nikspolaroid/eplan-vfd-conveyor-cabinet/fusion-3d/CAB1_VFD_conveyor_cabinet.step

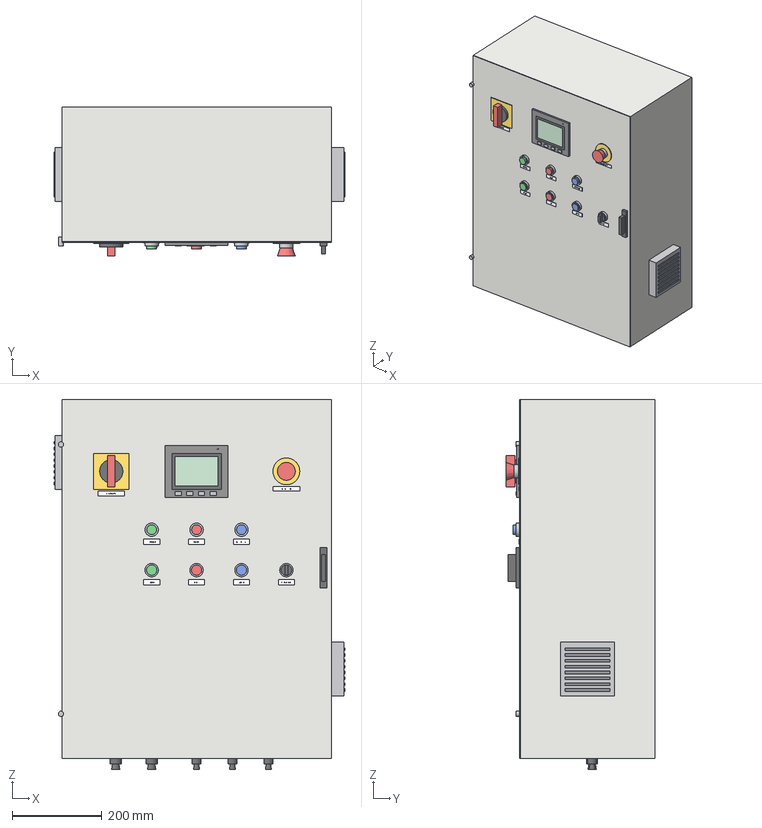
[picture p3: CAD file, 2026-11-06]
fusion-3d/CAB1_VFD_conveyor_cabinet.step
647.0 x 332.0 x 824.0 mm
