nikspolaroid/eplan-vfd-conveyor-cabinet/(list of files, cad)

Other CAD files:
fusion-3d/CAB1_VFD_conveyor_cabinet.f3d
