nikspolaroid/eplan-vfd-conveyor-cabinet/docs/CAB1_VFD_CONVEYOR_schematic.pdf

93415

## Petersgasse

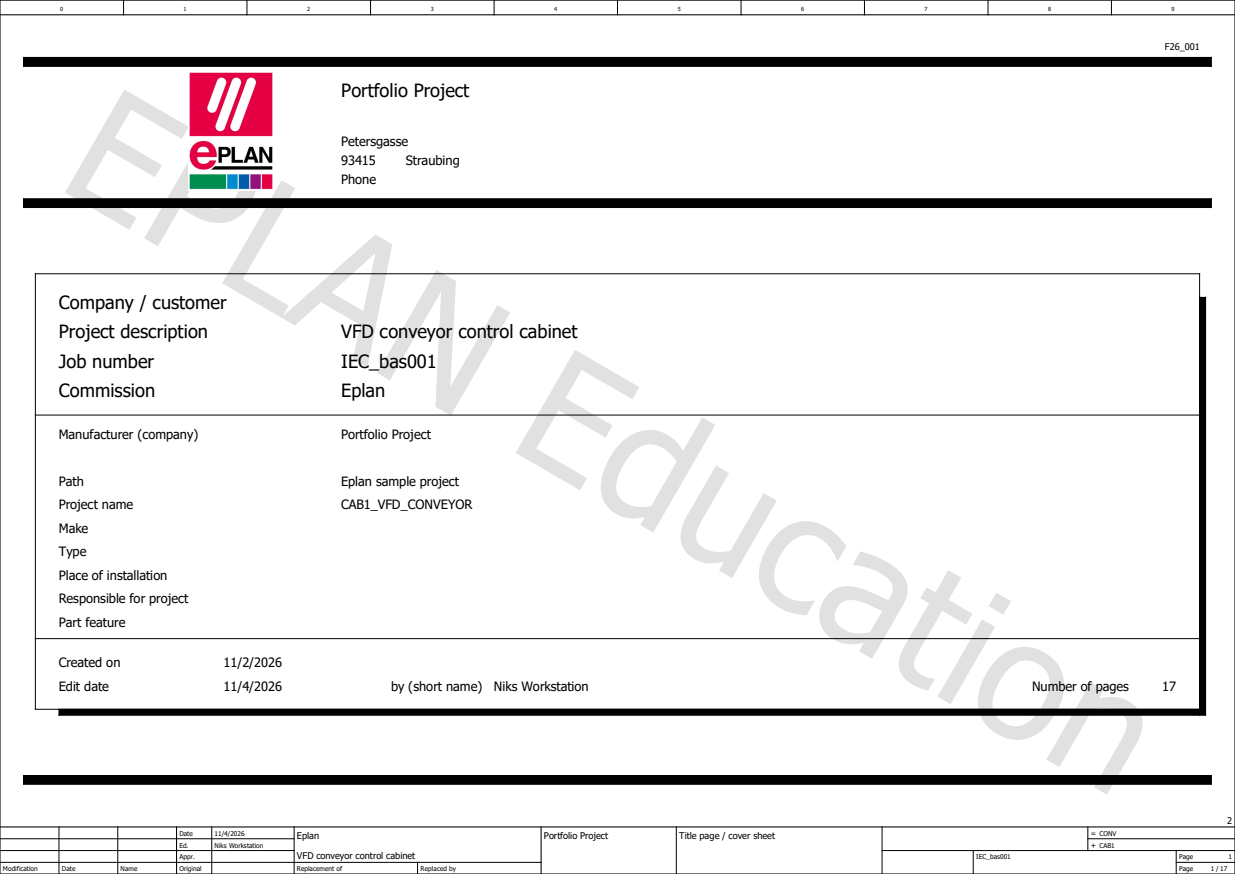
[picture p4: page 1]
Portfolio Project; Project description; VFD conveyor control cabinet; Commission; Edit date; IEC_bas001; Created on; Job number; Niks Workstation; Manufacturer (company); Project name; CAB1_VFD_CONVEYOR; Phone; Company / customer; Eplan; Straubing

Path
Make
Type
Place of installation
Responsible for project
Part feature

Eplan sample project

by (short name)

Number of pages

11/4/2026 | Eplan VFD conveyor control cabinet | Portfolio Project | Title page / cover sheet | = CONV

Ed. | Niks Workstation | | | | + CAB1
Appr. | | | | | IEC_bas001 | Page

Modification | Date | Name | Original | | Replacement of | Replaced by | | | | 1 / 17

Page | Page type | Page description | Date | Edited by

# Table of contents

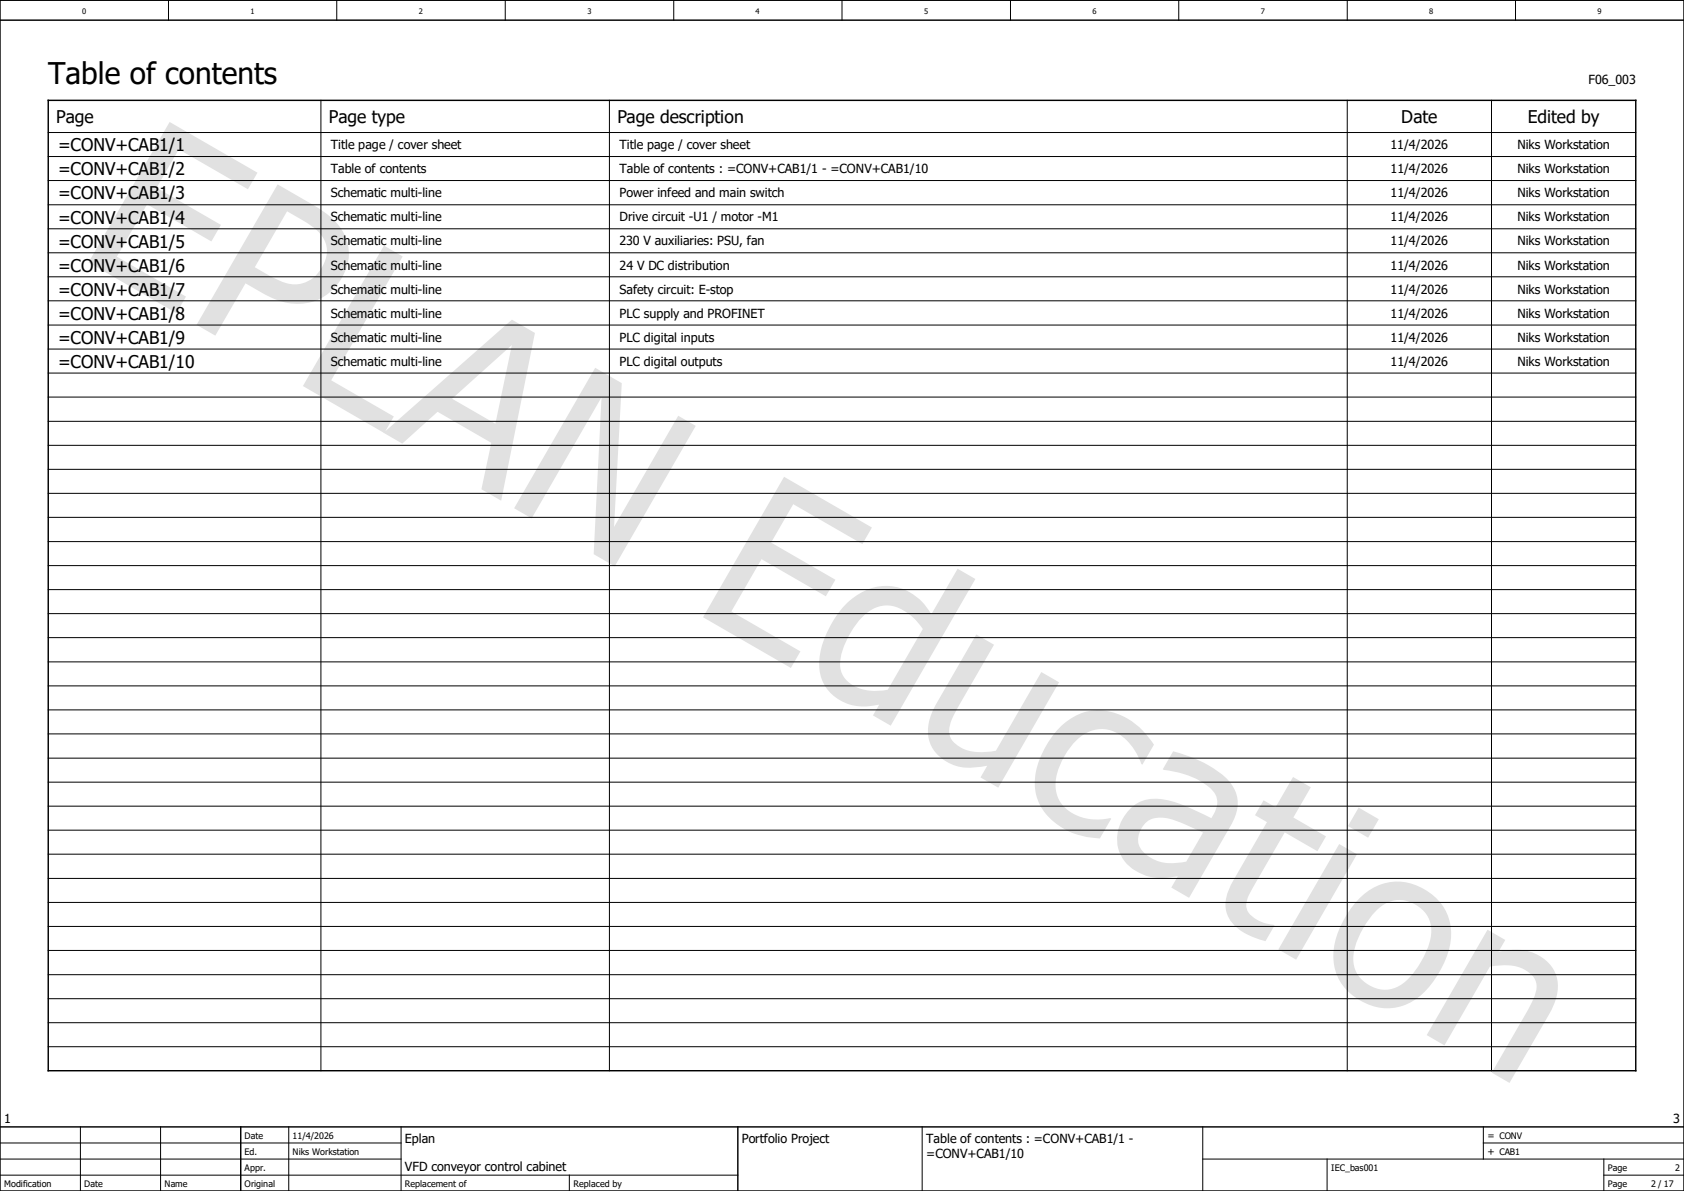
[picture p5: page 2]

=CONV+CAB1/1 | Title page / cover sheet | | 11/4/2026 Title page / cover sheet | Niks Workstation
=CONV+CAB1/2 | Table of contents | | 11/4/2026 Table of contents : =CONV+CAB1/1 - =CONV+CAB1/10 | Niks Workstation
=CONV+CAB1/3 | Schematic multi-line | Power infeed and main switch | 11/4/2026 | Niks Workstation
=CONV+CAB1/4 | Schematic multi-line | Drive circuit -U1 / motor -M1 | 11/4/2026 | Niks Workstation
=CONV+CAB1/5 | Schematic multi-line | 230 V auxiliaries: PSU, fan | 11/4/2026 | Niks Workstation
=CONV+CAB1/6 | Schematic multi-line | 24 V DC distribution | 11/4/2026 | Niks Workstation
=CONV+CAB1/7 | Schematic multi-line | Safety circuit: E-stop | 11/4/2026 | Niks Workstation
=CONV+CAB1/8 | Schematic multi-line | PLC supply and PROFINET | 11/4/2026 | Niks Workstation
=CONV+CAB1/9 | Schematic multi-line | PLC digital inputs | 11/4/2026 | Niks Workstation
=CONV+CAB1/10 | Schematic multi-line | PLC digital outputs | 11/4/2026 | Niks Workstation

Table of contents : =CONV+CAB1/1 -
=CONV+CAB1/10

-W0 | 3⁻1 | 3⁻1 | 3⁻1 4⁻1 | 4⁻1 | 4⁻1 | 4⁻15⁻1

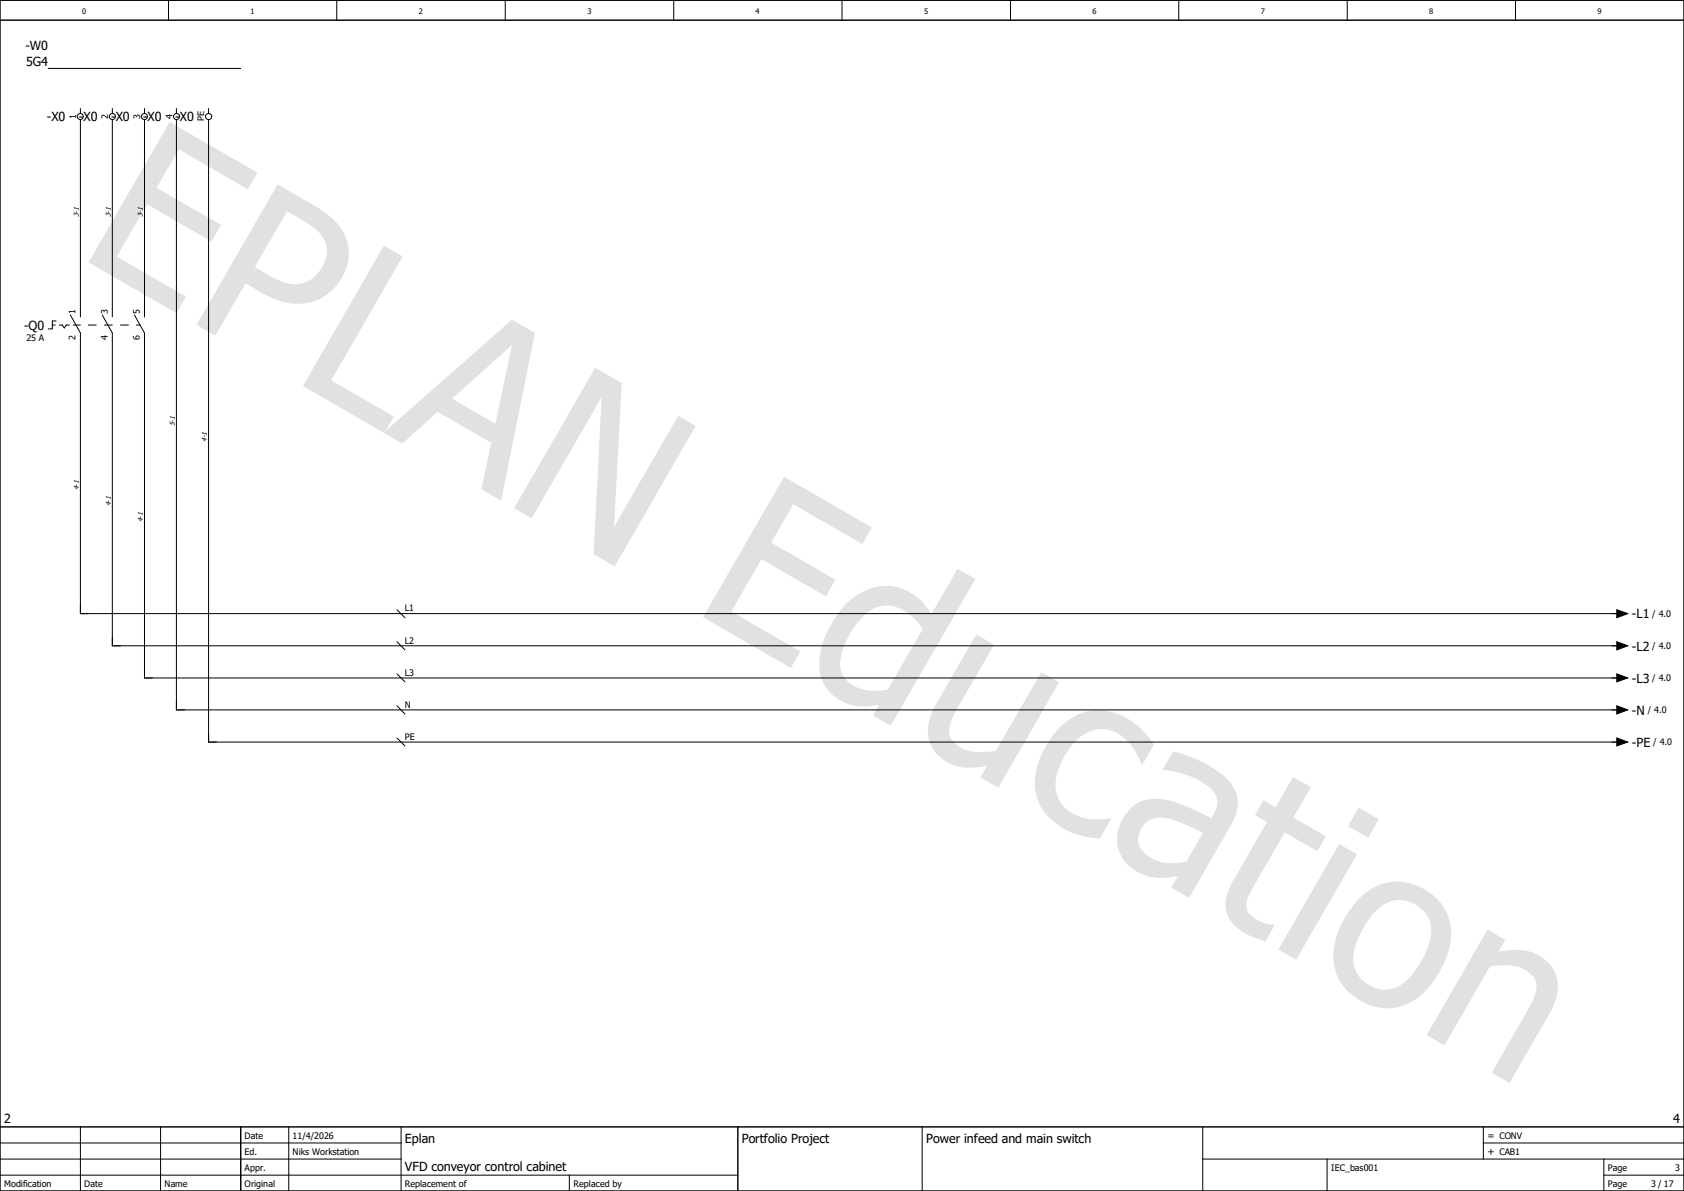
[picture p6: page 3]

Power infeed and main switch

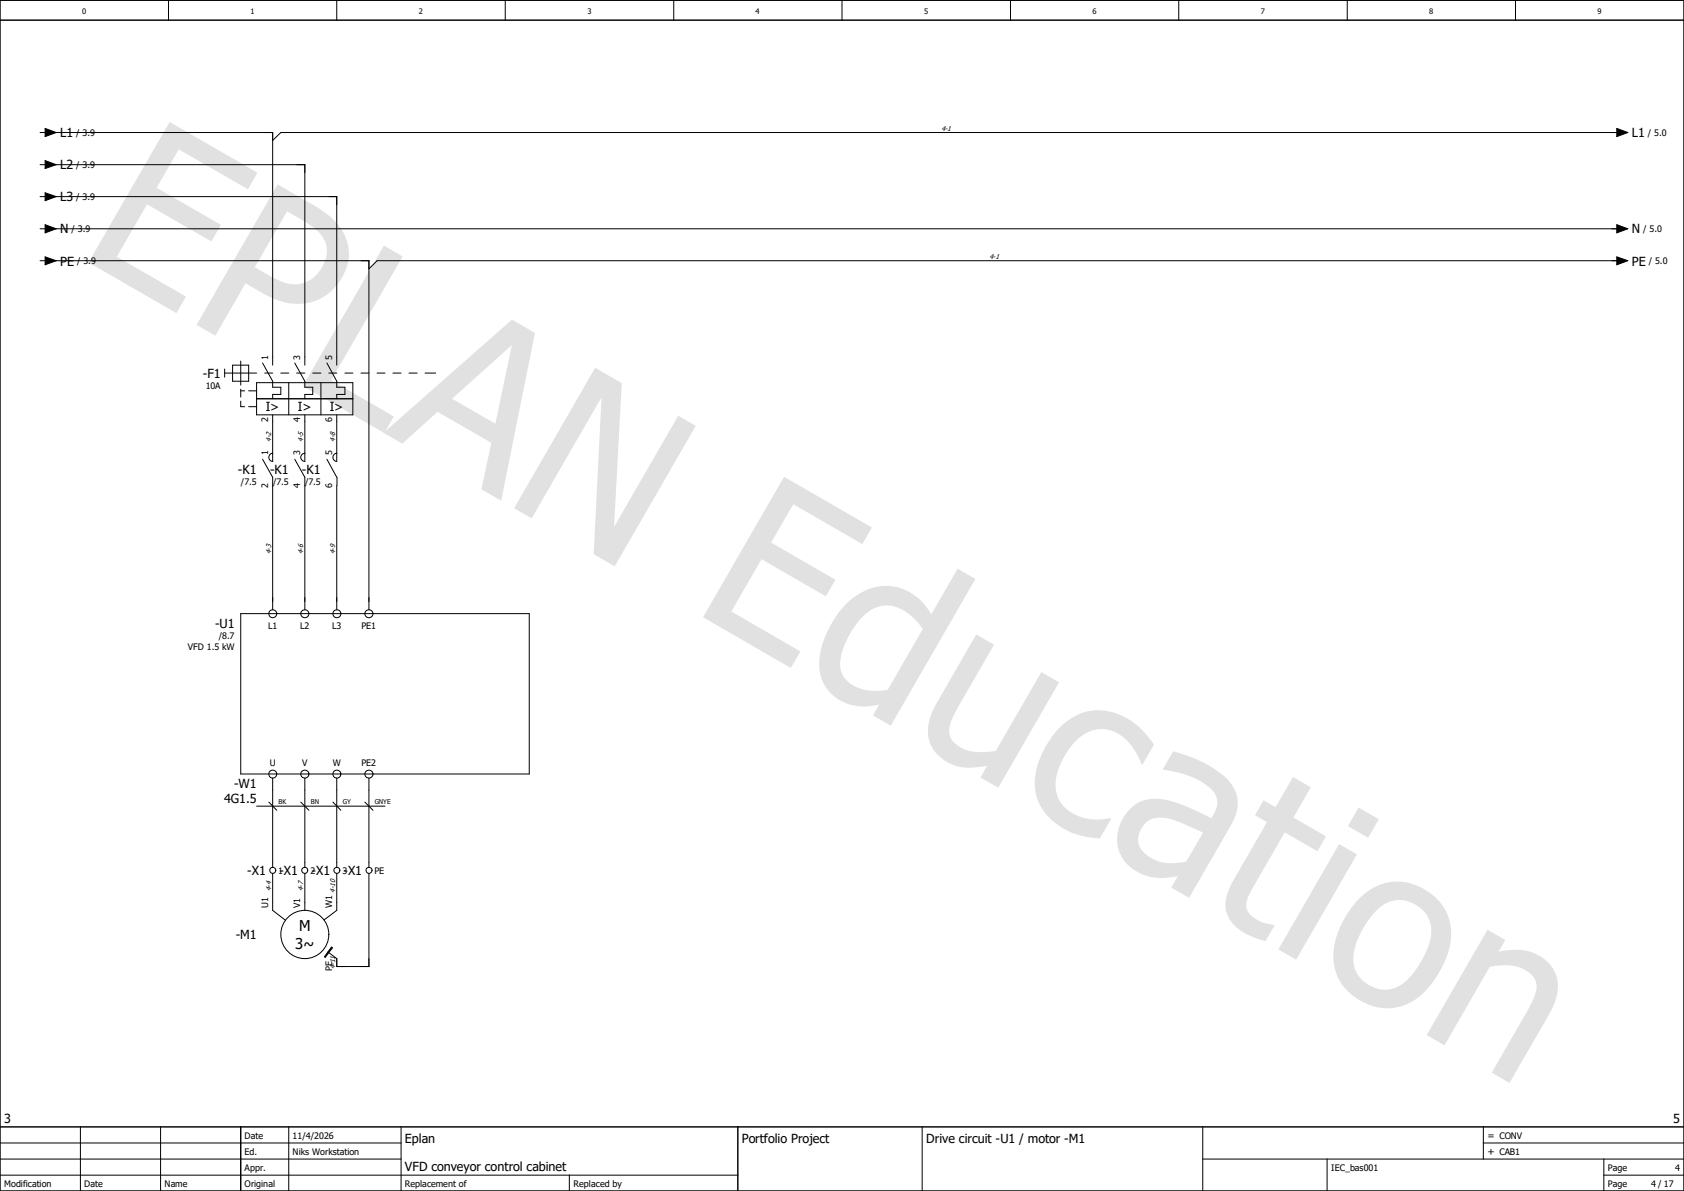
[picture p7: page 4]
-U1 /8.7 VFD 1.5 kW; GNYE U¹

Drive circuit -U1 / motor -M1

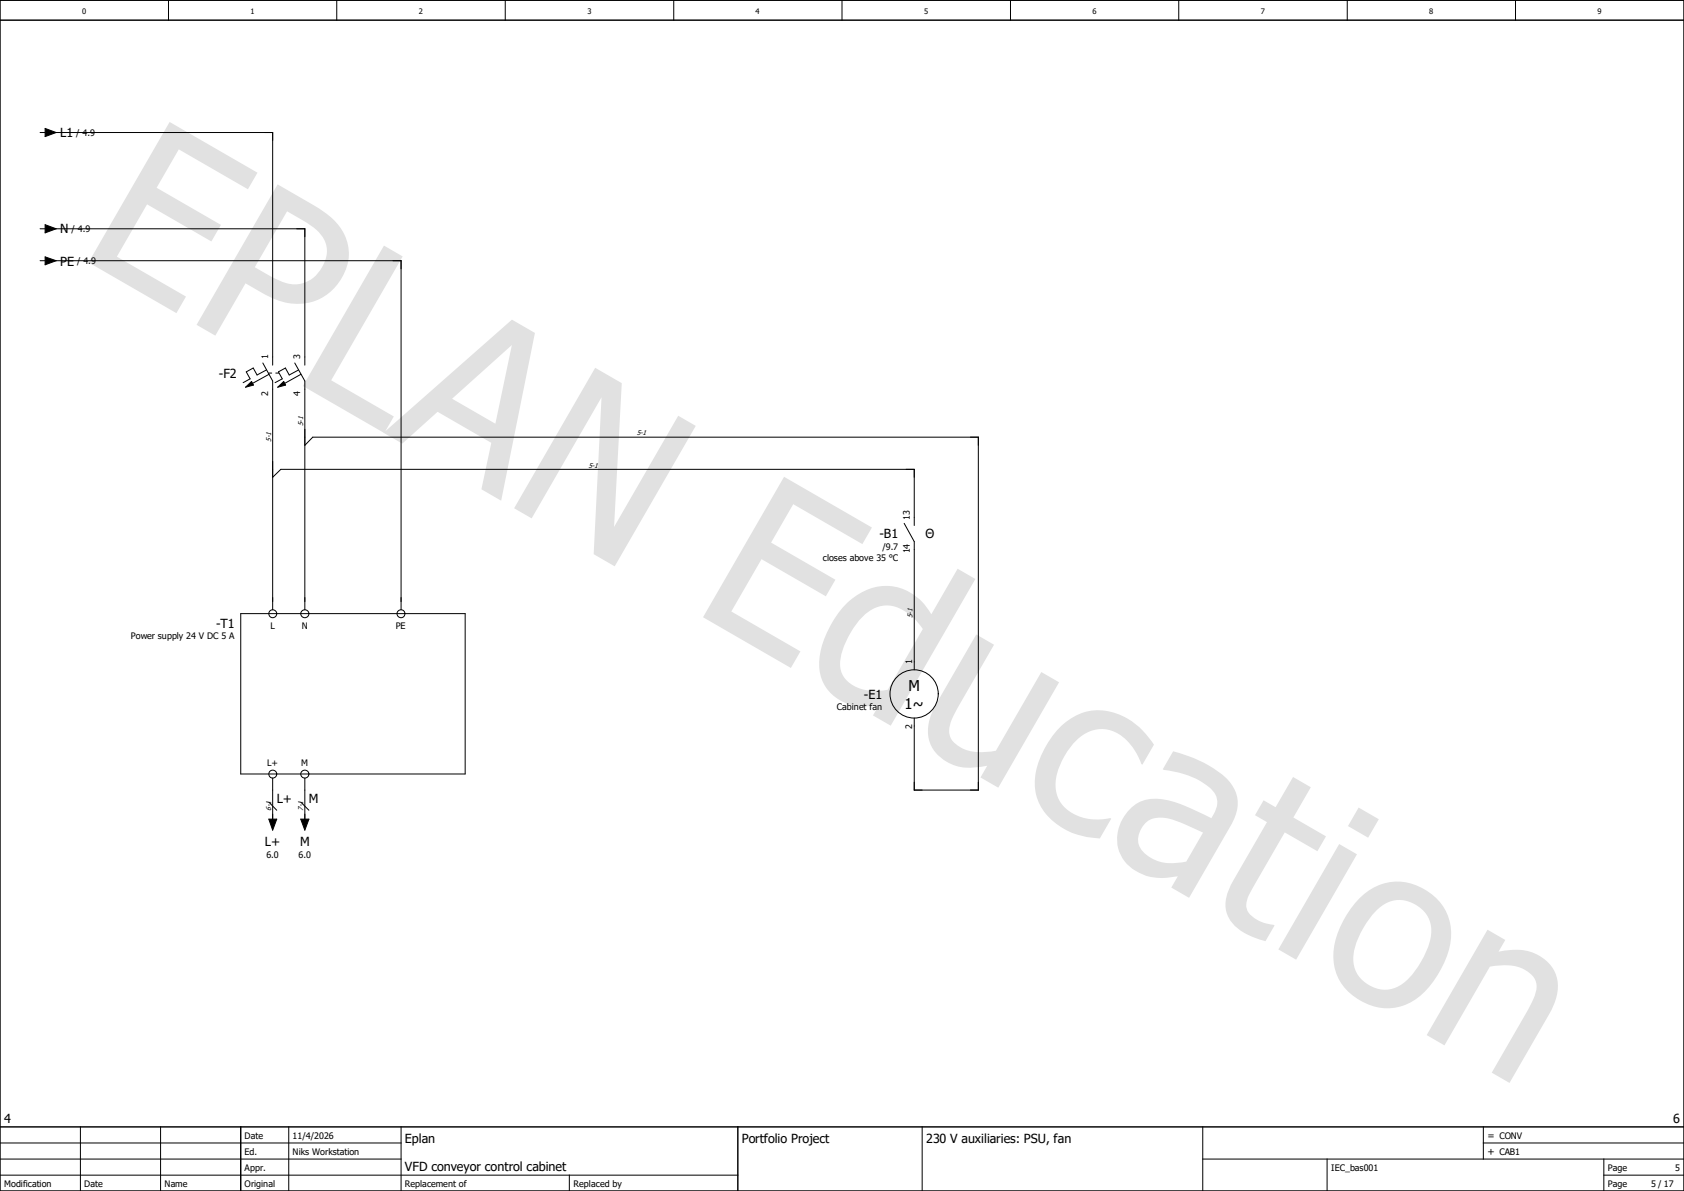
[picture p8: page 5]
-B1 /9.7 closes above 35 °C; Cabinet fan

Power supply 24 V DC 5 A

230 V auxiliaries: PSU, fan

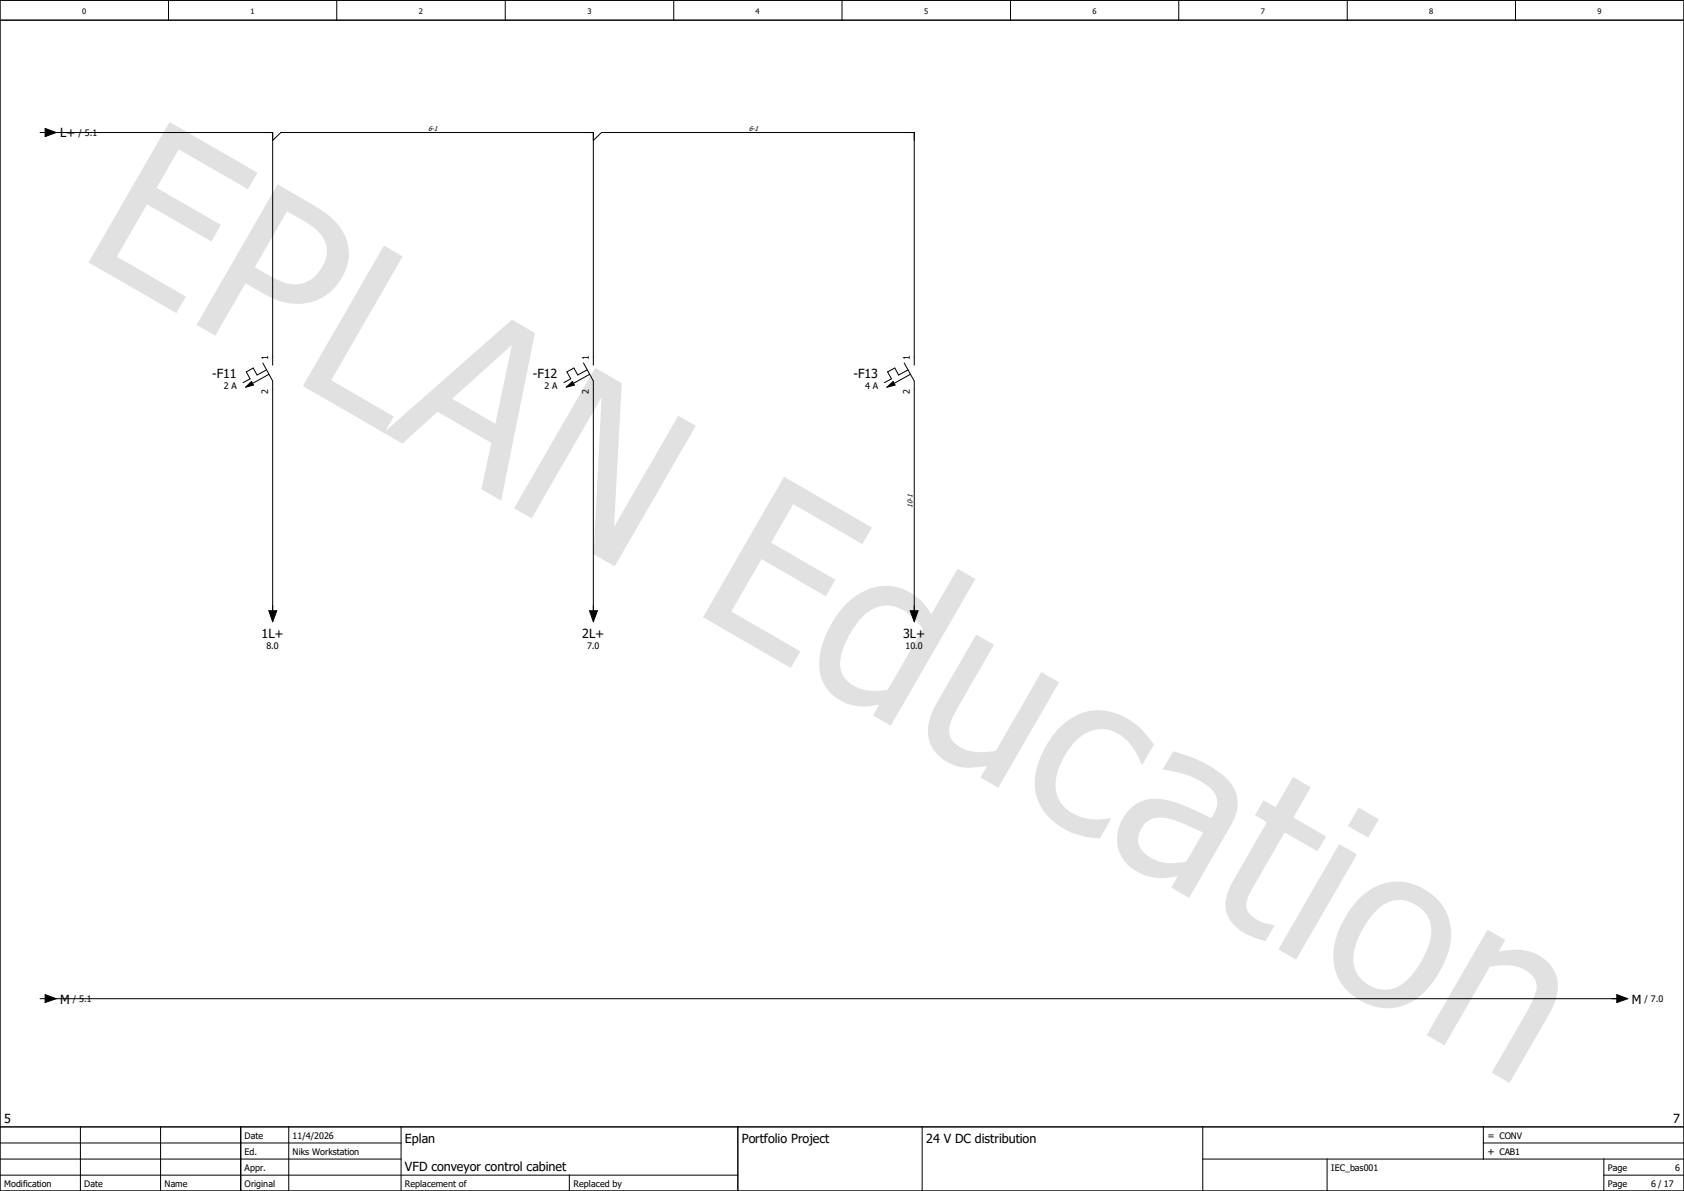
[picture p9: page 6]
24 V DC distribution

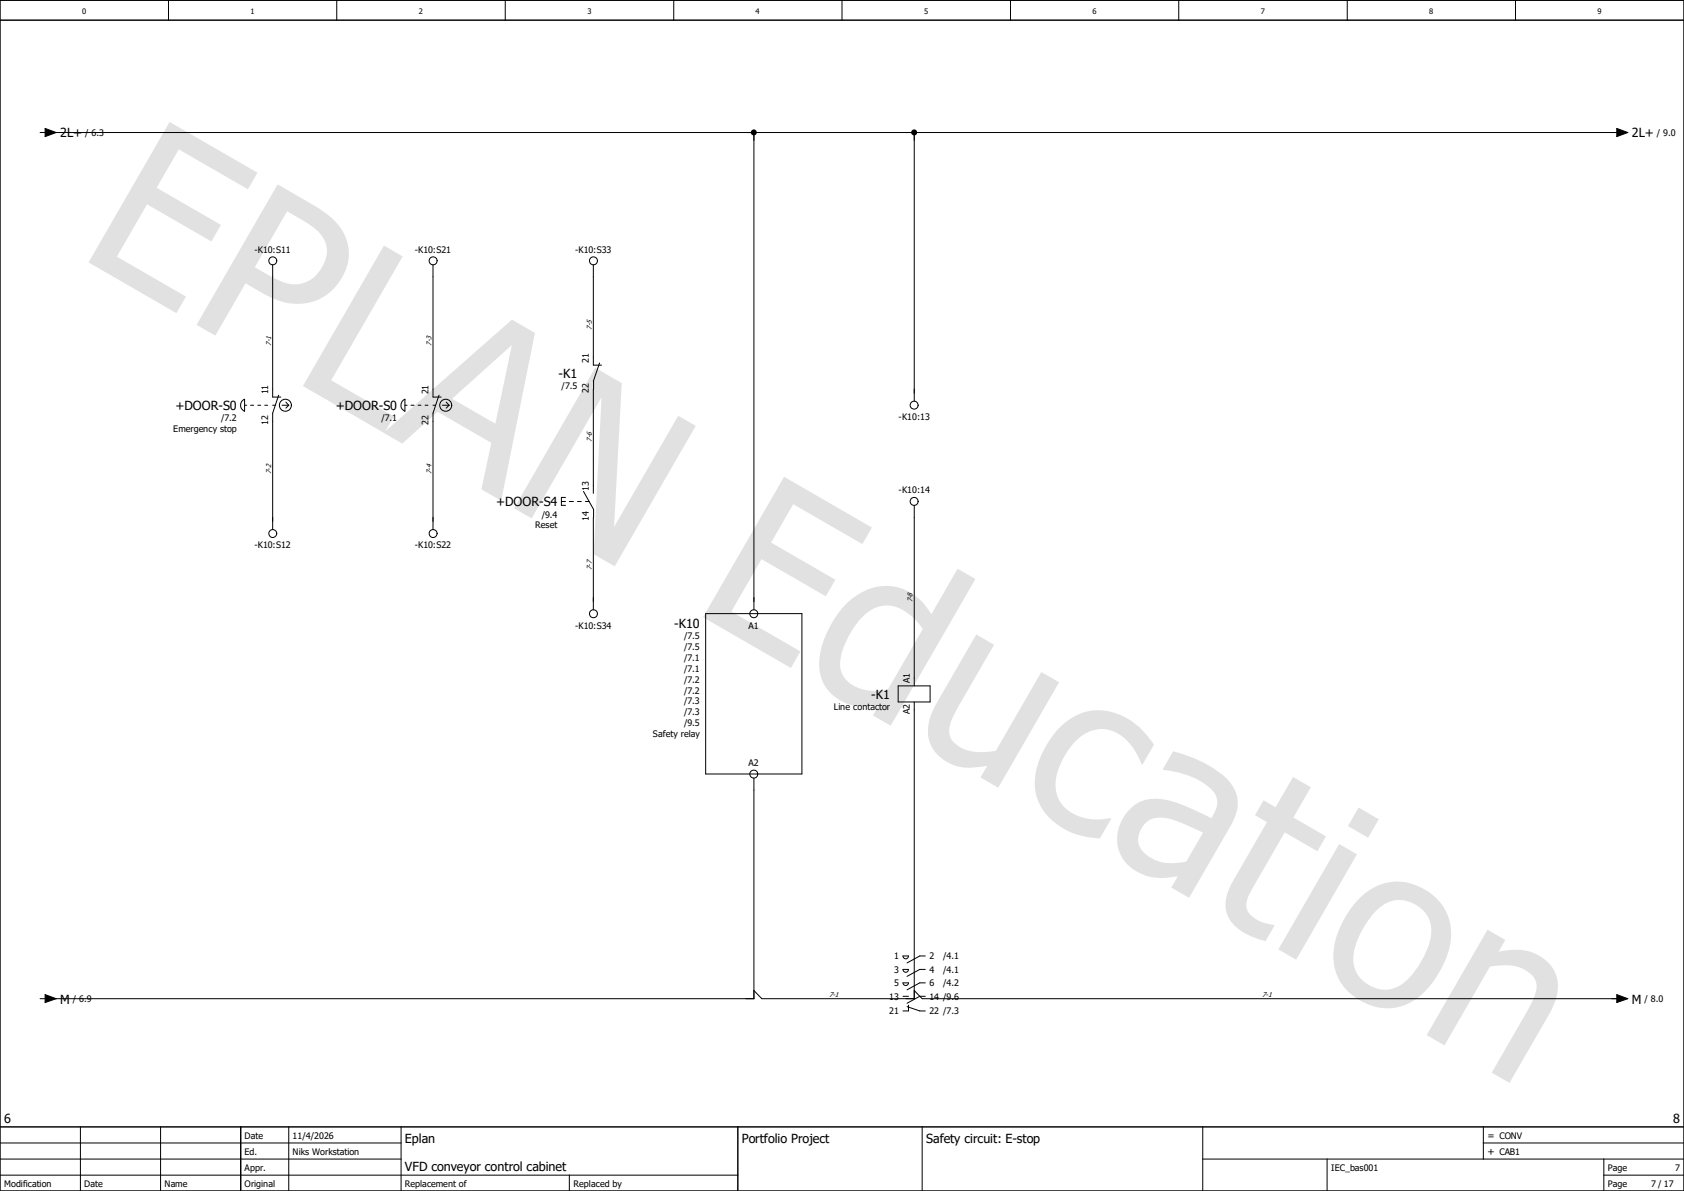
[picture p10: page 7]
+DOOR-S0 /7.2; Emergency stop; +DOOR-S0; +DOOR-S4 /9.4 Reset; -K10 /7.5 /7.5 /7.1 /7.1 /7.2 /7.2 /7.3 /7.3 /9.5 Safety relay; -K1 Line contactor

Safety circuit: E-stop

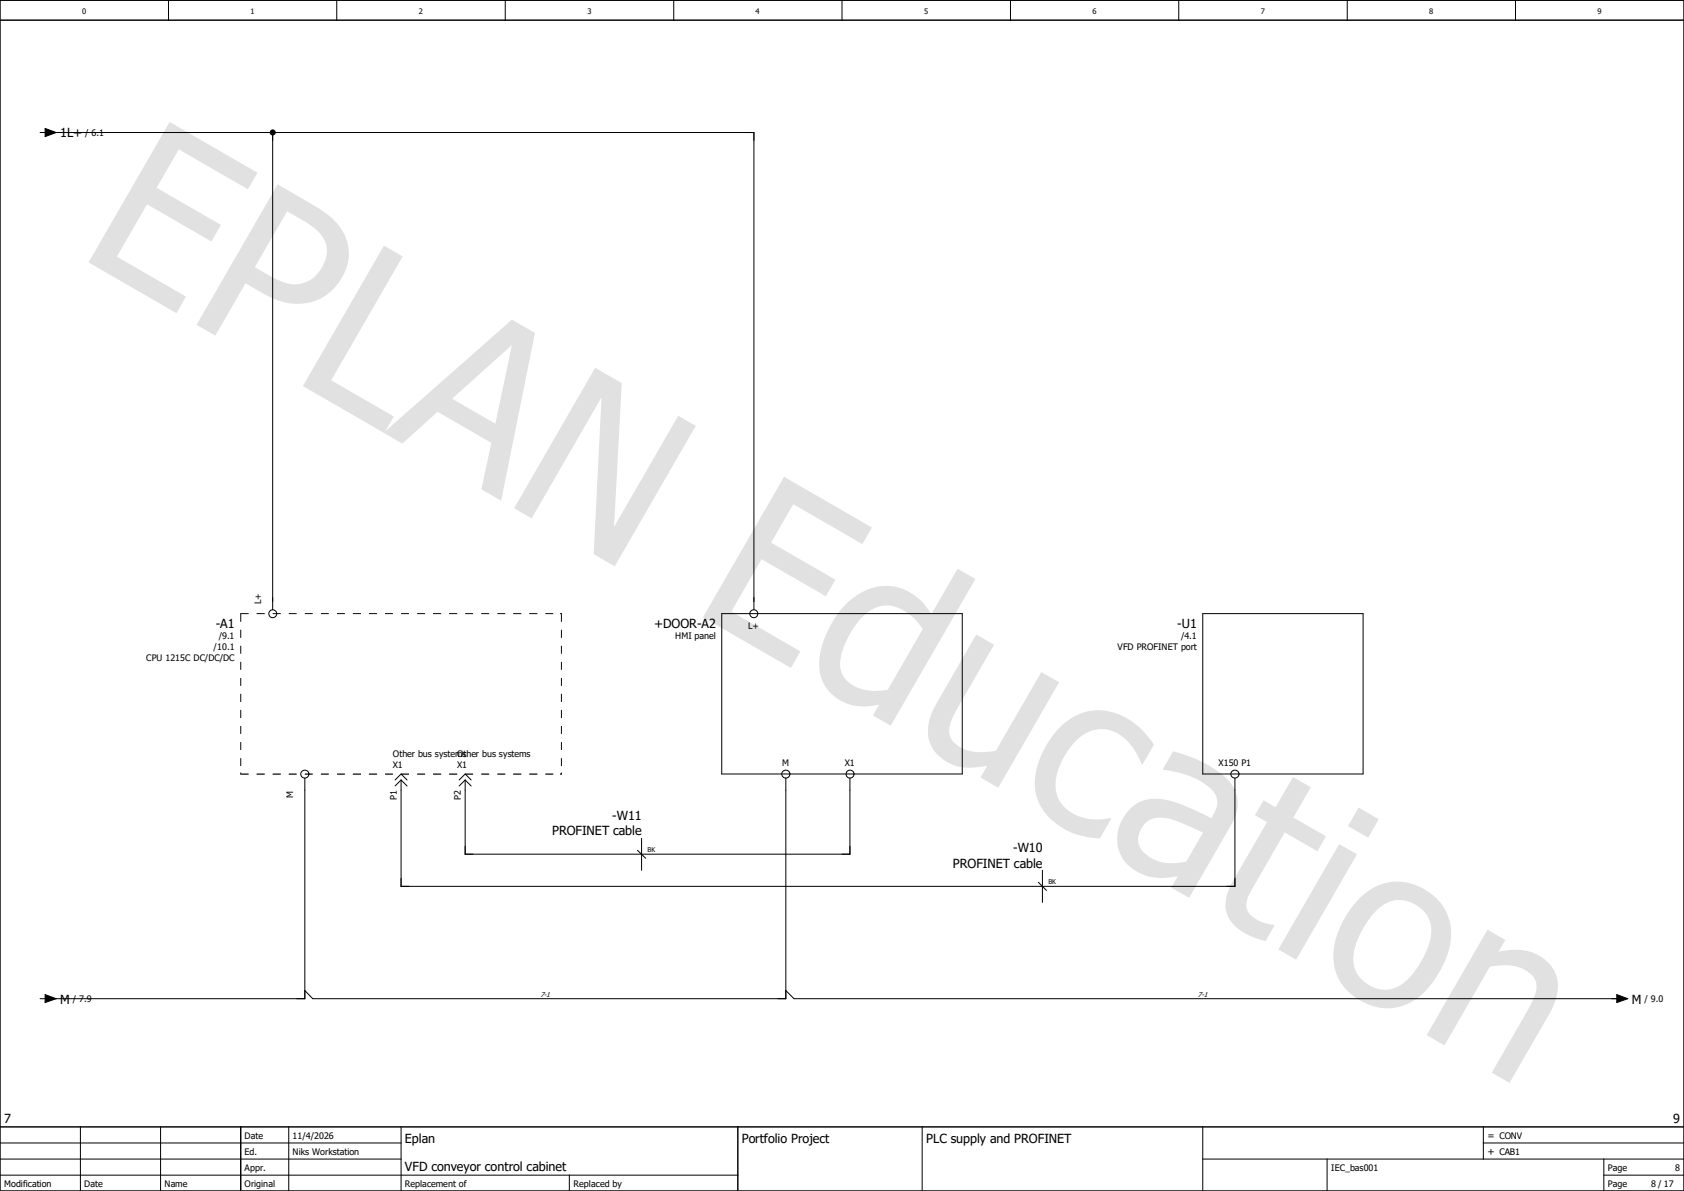
[picture p11: page 8]
CPU 1215C DC/DC/DC; Other bus systemsP2; +DOOR-A2 HMI panel; PROFINET cable

VFD PROFINET port

Other bus systems

PLC supply and PROFINET

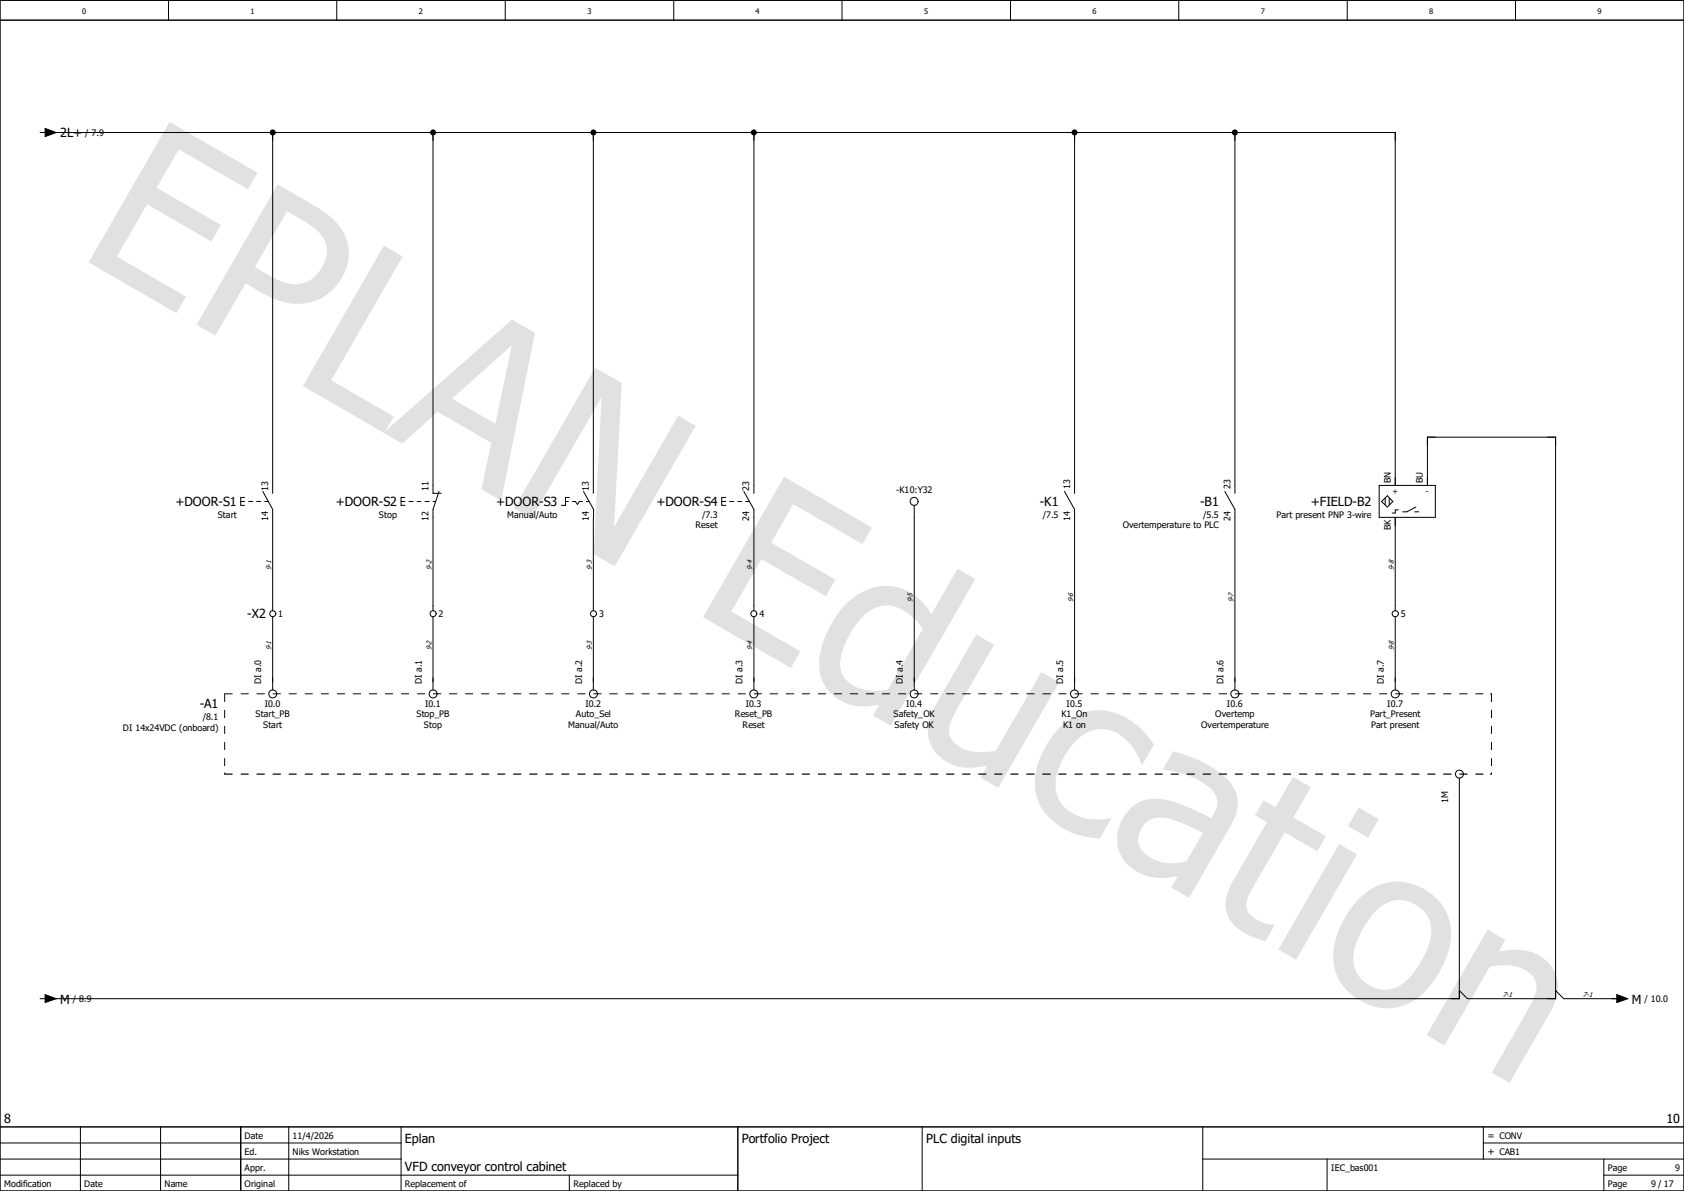
[picture p12: page 9]
-A1 /8.1 DI 14x24VDC (onboard); I0.0 Start_PB; Start DI a.0; I0.1 Stop_PB; Stop DI a.1; I0.2 Auto_Sel; I0.3 Reset_PB; Reset DI a.3; I0.4 Safety_OK; I0.6 Overtemp; Overtemperature DI a.6; I0.7 Part_Present; Part present DI a.7; +DOOR-S1; Start; +DOOR-S4 /7.3; +DOOR-S2; Stop; +DOOR-S3; Manual/Auto; +FIELD-B2

Reset ¹¹ ¹²

Overtemperature to PLC

Part present PNP 3-wire

Manual/Auto DI a.2

Safety OK DI a.4

PLC digital inputs

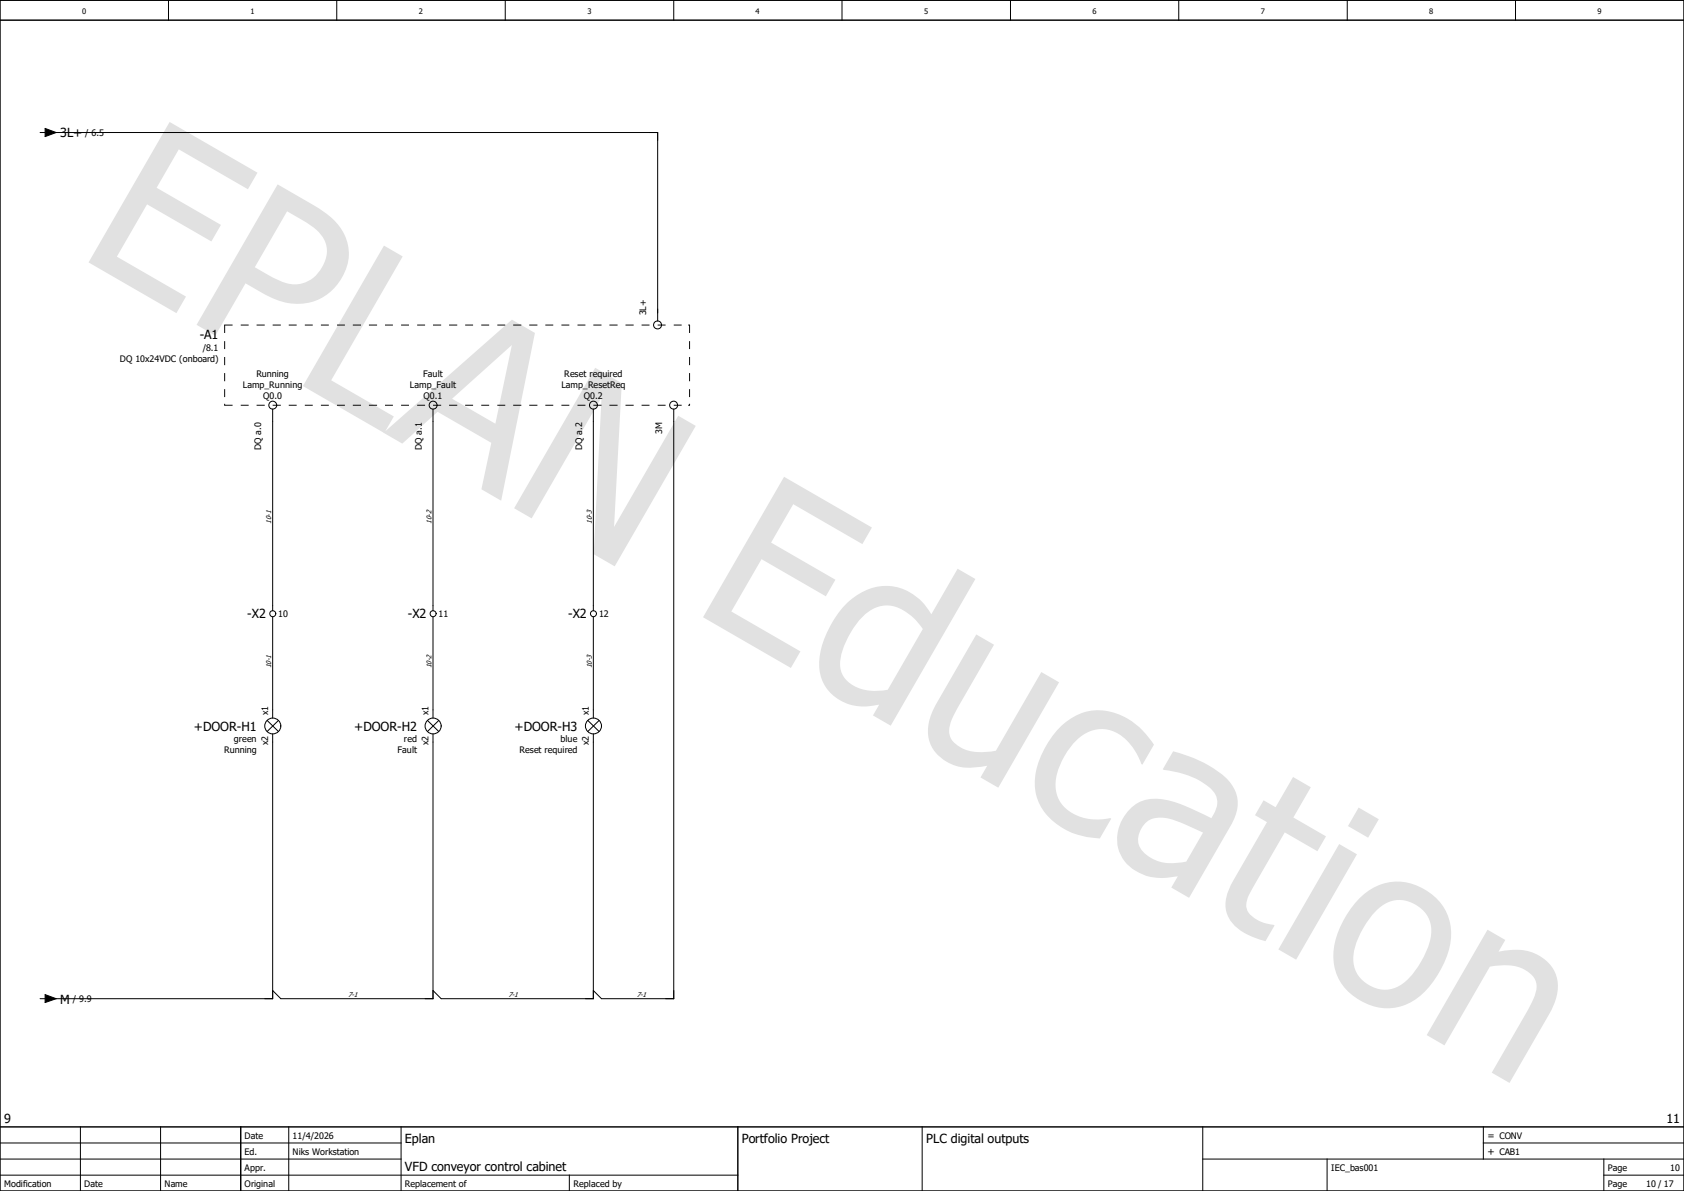
[picture p13: page 10]
DQ 10x24VDC (onboard); Lamp_Running; Running; Lamp_Fault; Fault; Lamp_ResetReq; Reset required; +DOOR-H1 green; +DOOR-H2 red; +DOOR-H3 blue; Reset required ¹⁰⁻¹

PLC digital outputs

# 11 / Cable type

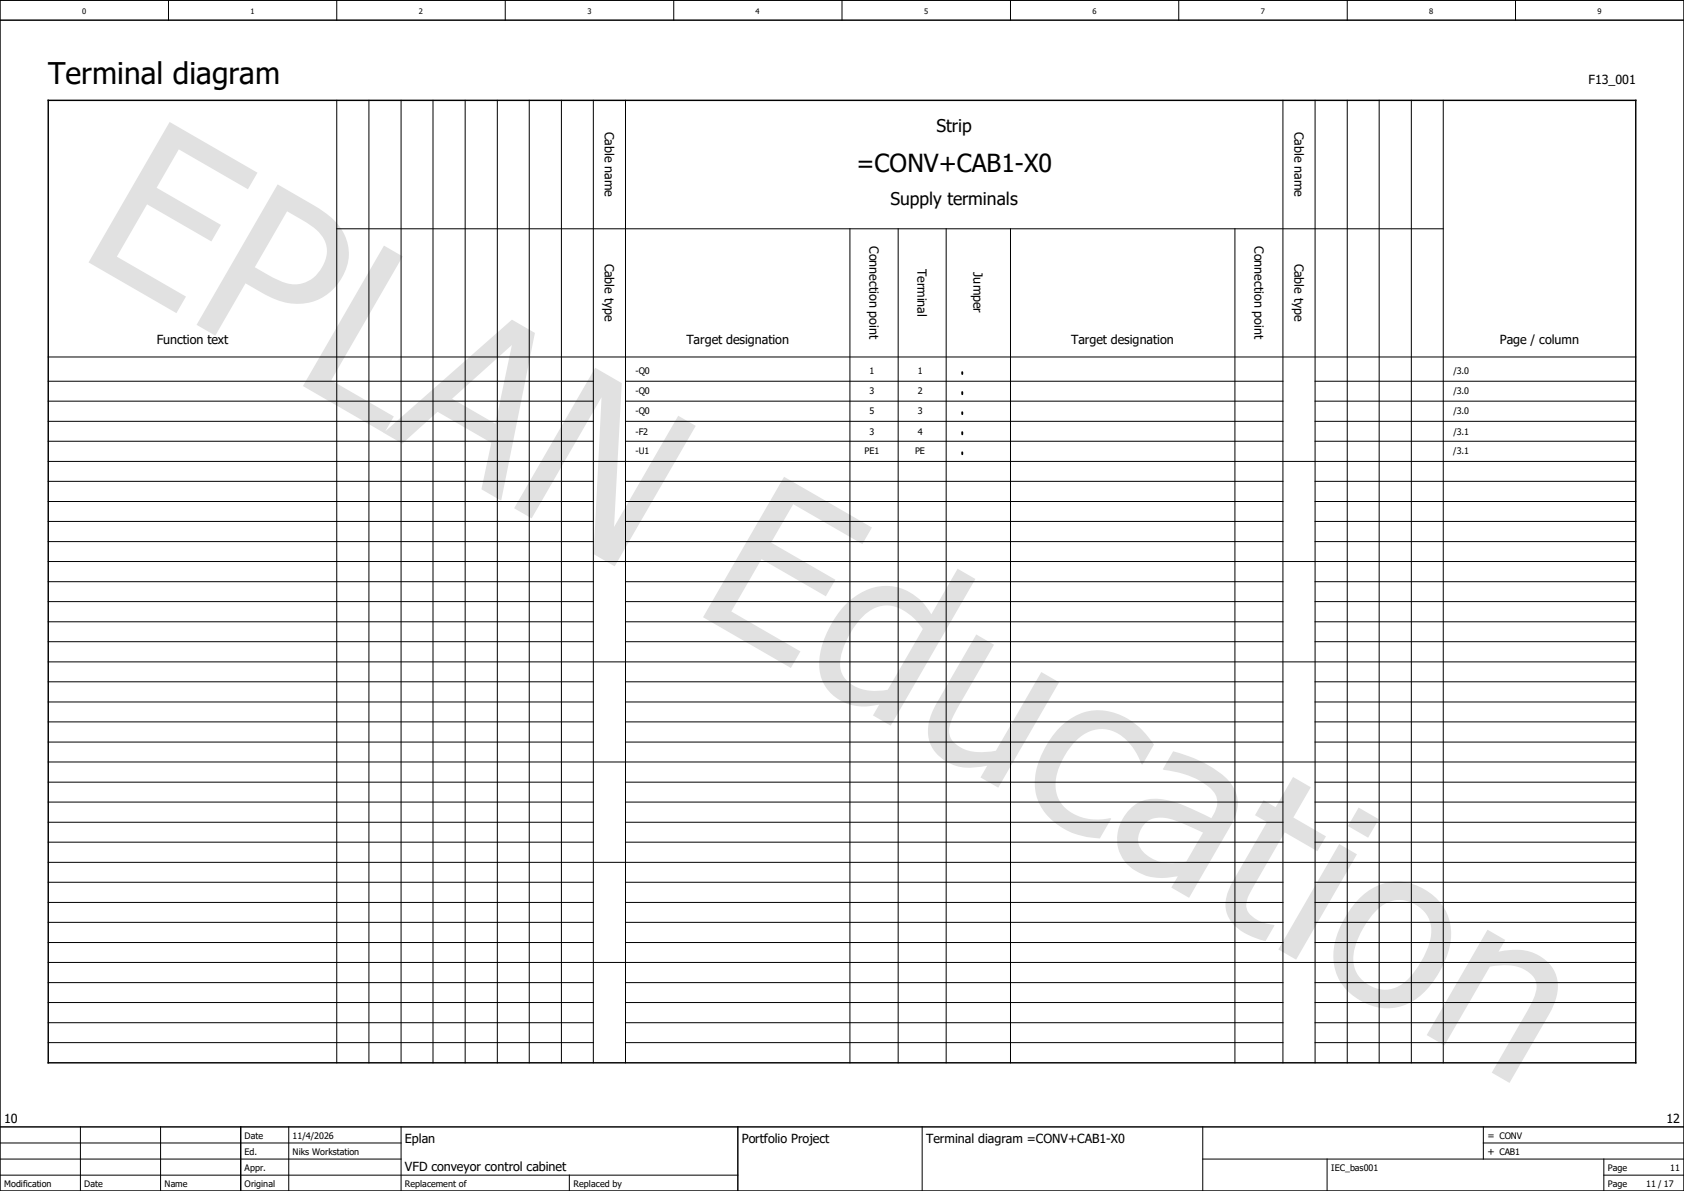
[picture p14: page 11]
Page / column Cable name; Strip

Terminal diagram Function text | | Connection point =CONV+CAB1-X0 Supply terminals | | | | | F13_001 Cable name

Target designation | | | Jumper | Target designation Cable type | Connection point Terminal

-Q0 | 1 | 1 | | | | /3.0
-Q0 | 3 | 2 | | | | /3.0
-Q0 | 5 | 3 | | | | /3.0
-F2 | 3 | 4 | | | | /3.1
-U1 | PE1 | PE | | | | /3.1

Terminal diagram =CONV+CAB1-X0

# 12 / Cable type

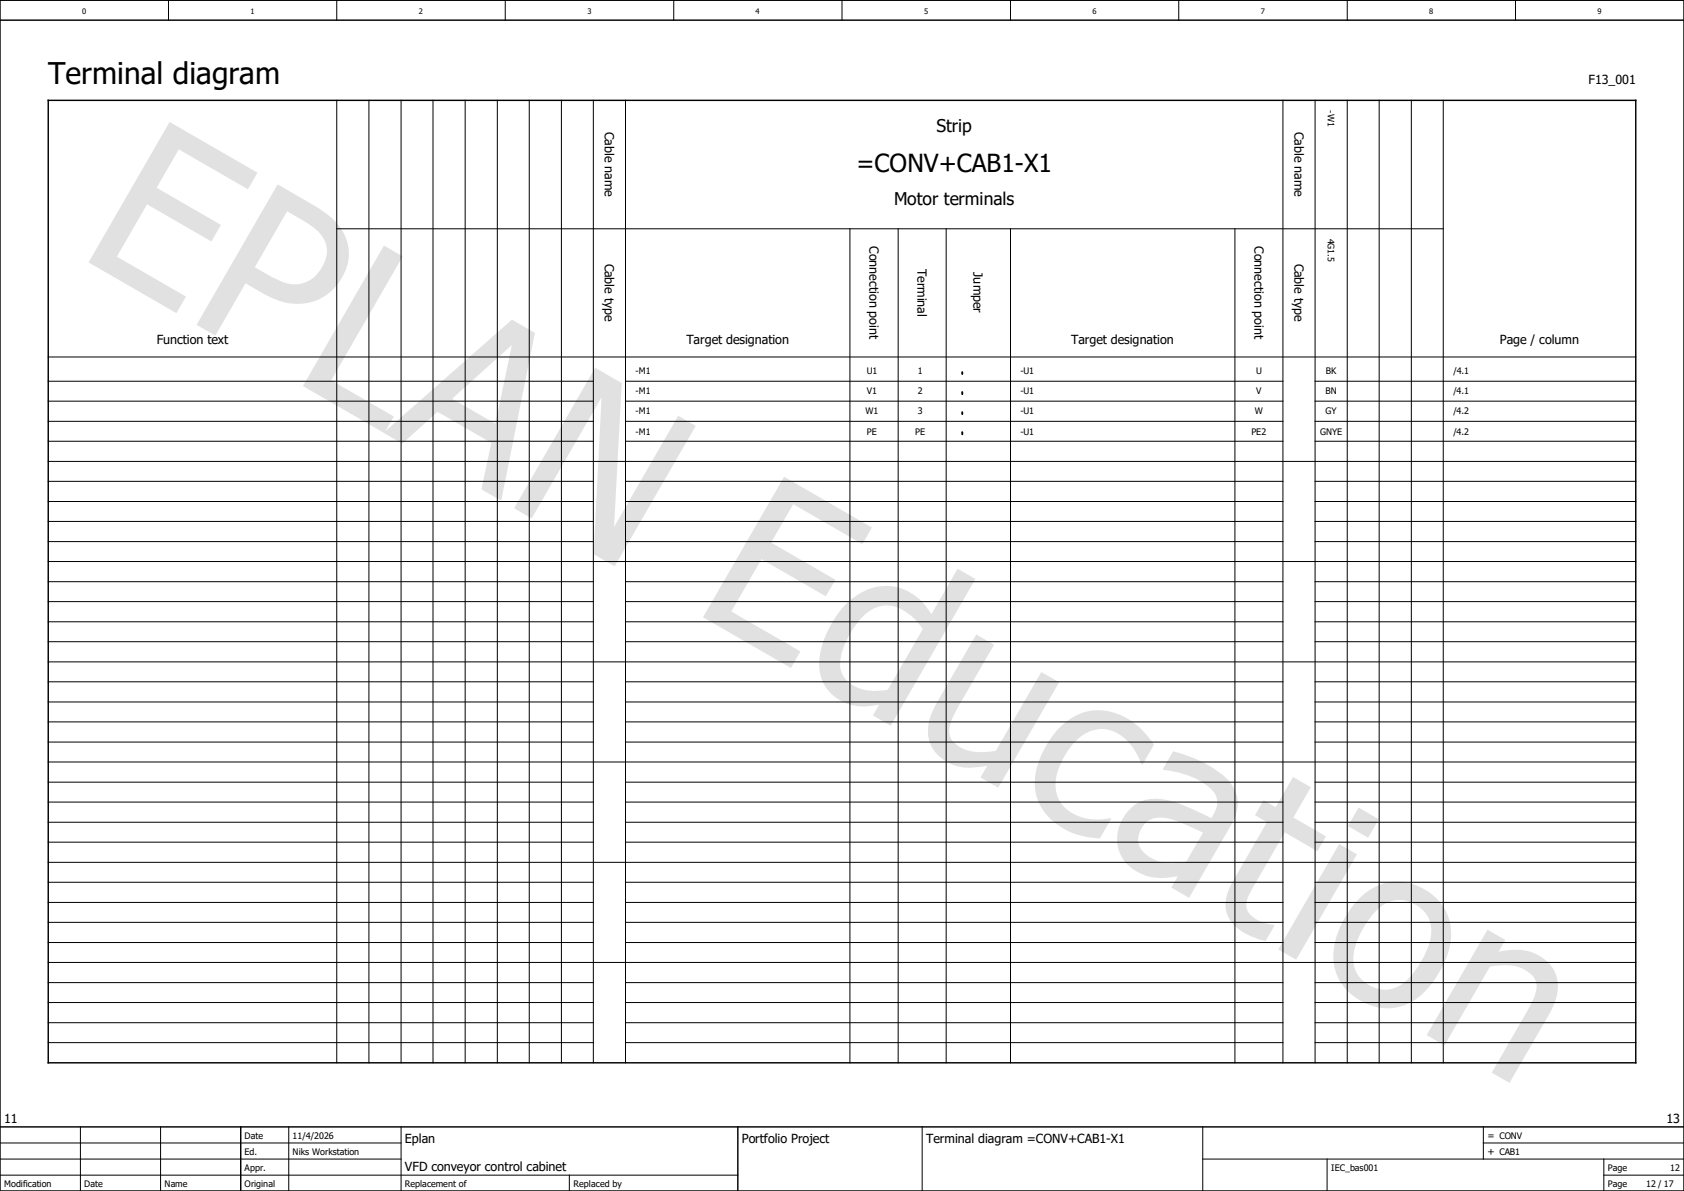
[picture p15: page 12]
Page / column Cable name; Strip

Terminal diagram Function text | | Connection point =CONV+CAB1-X1 Motor terminals | 4G1.5 ⁻W1 | | | | F13_001 Cable name

Target designation | | Jumper | Target designation Cable type | Connection point Terminal

-M1 | 1 | | | U U1 | | BK | /4.1 -U1
-M1 | 2 | | | V V1 | | BN | /4.1 -U1
-M1 | 3 | | | W W1 | | GY | /4.2 -U1
-M1 | PE | | | PE2 PE | | GNYE | /4.2 -U1

Terminal diagram =CONV+CAB1-X1

# 13 / Cable type

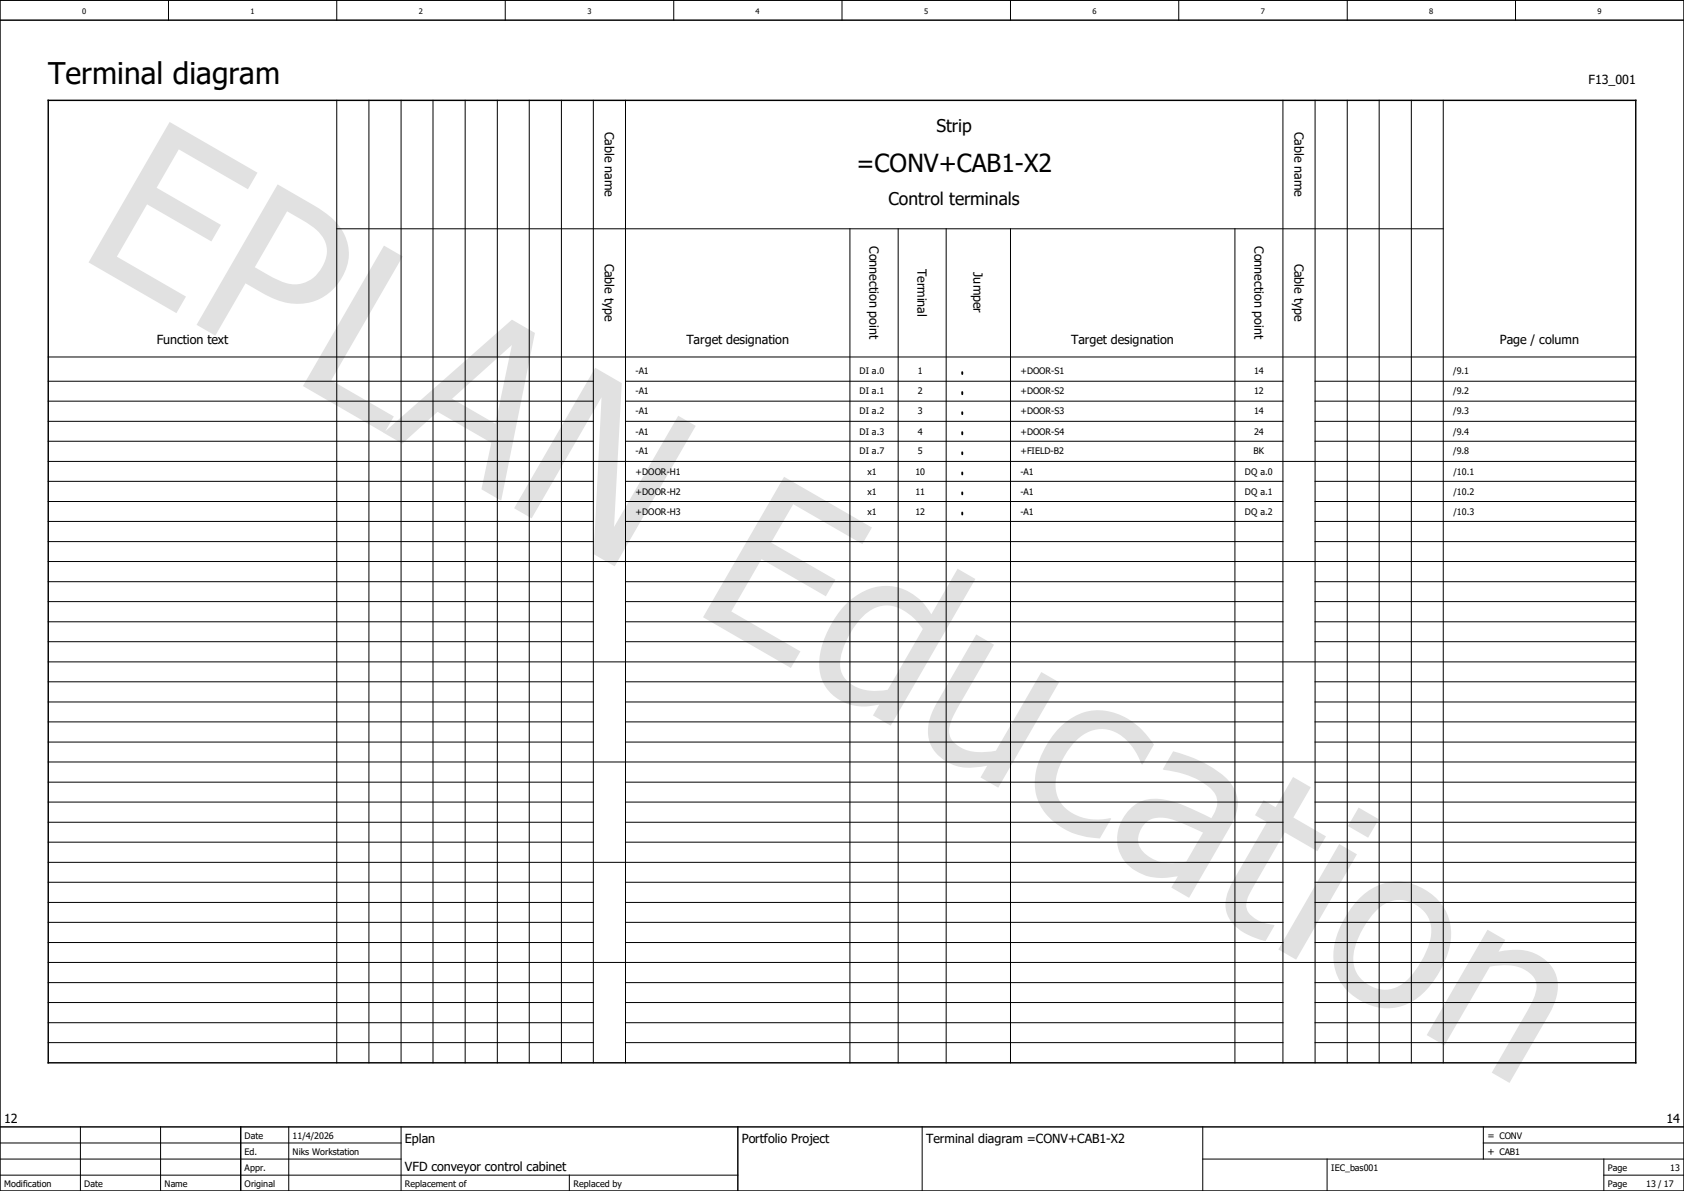
[picture p16: page 13]
Page / column Cable name; Strip

Terminal diagram Function text | | Connection point =CONV+CAB1-X2 Control terminals | | | | | F13_001 Cable name

Target designation | | Jumper | Target designation Cable type | Connection point Terminal

-A1 | 1 | | | 14 DI a.0 | | /9.1 +DOOR-S1
-A1 | 2 | | | 12 DI a.1 | /9.2 +DOOR-S2
-A1 | 3 | | | 14 DI a.2 | /9.3 +DOOR-S3
-A1 | 4 | | | 24 DI a.3 | /9.4 +DOOR-S4
-A1 | 5 | | | BK DI a.7 | /9.8 +FIELD-B2
+DOOR-H1 | 10 | | -A1 | DQ a.0 x1 | | /10.1
+DOOR-H2 | 11 | | -A1 | DQ a.1 x1 | | /10.2
+DOOR-H3 | 12 | | -A1 | DQ a.2 x1 | | /10.3

Terminal diagram =CONV+CAB1-X2

# Cable overview

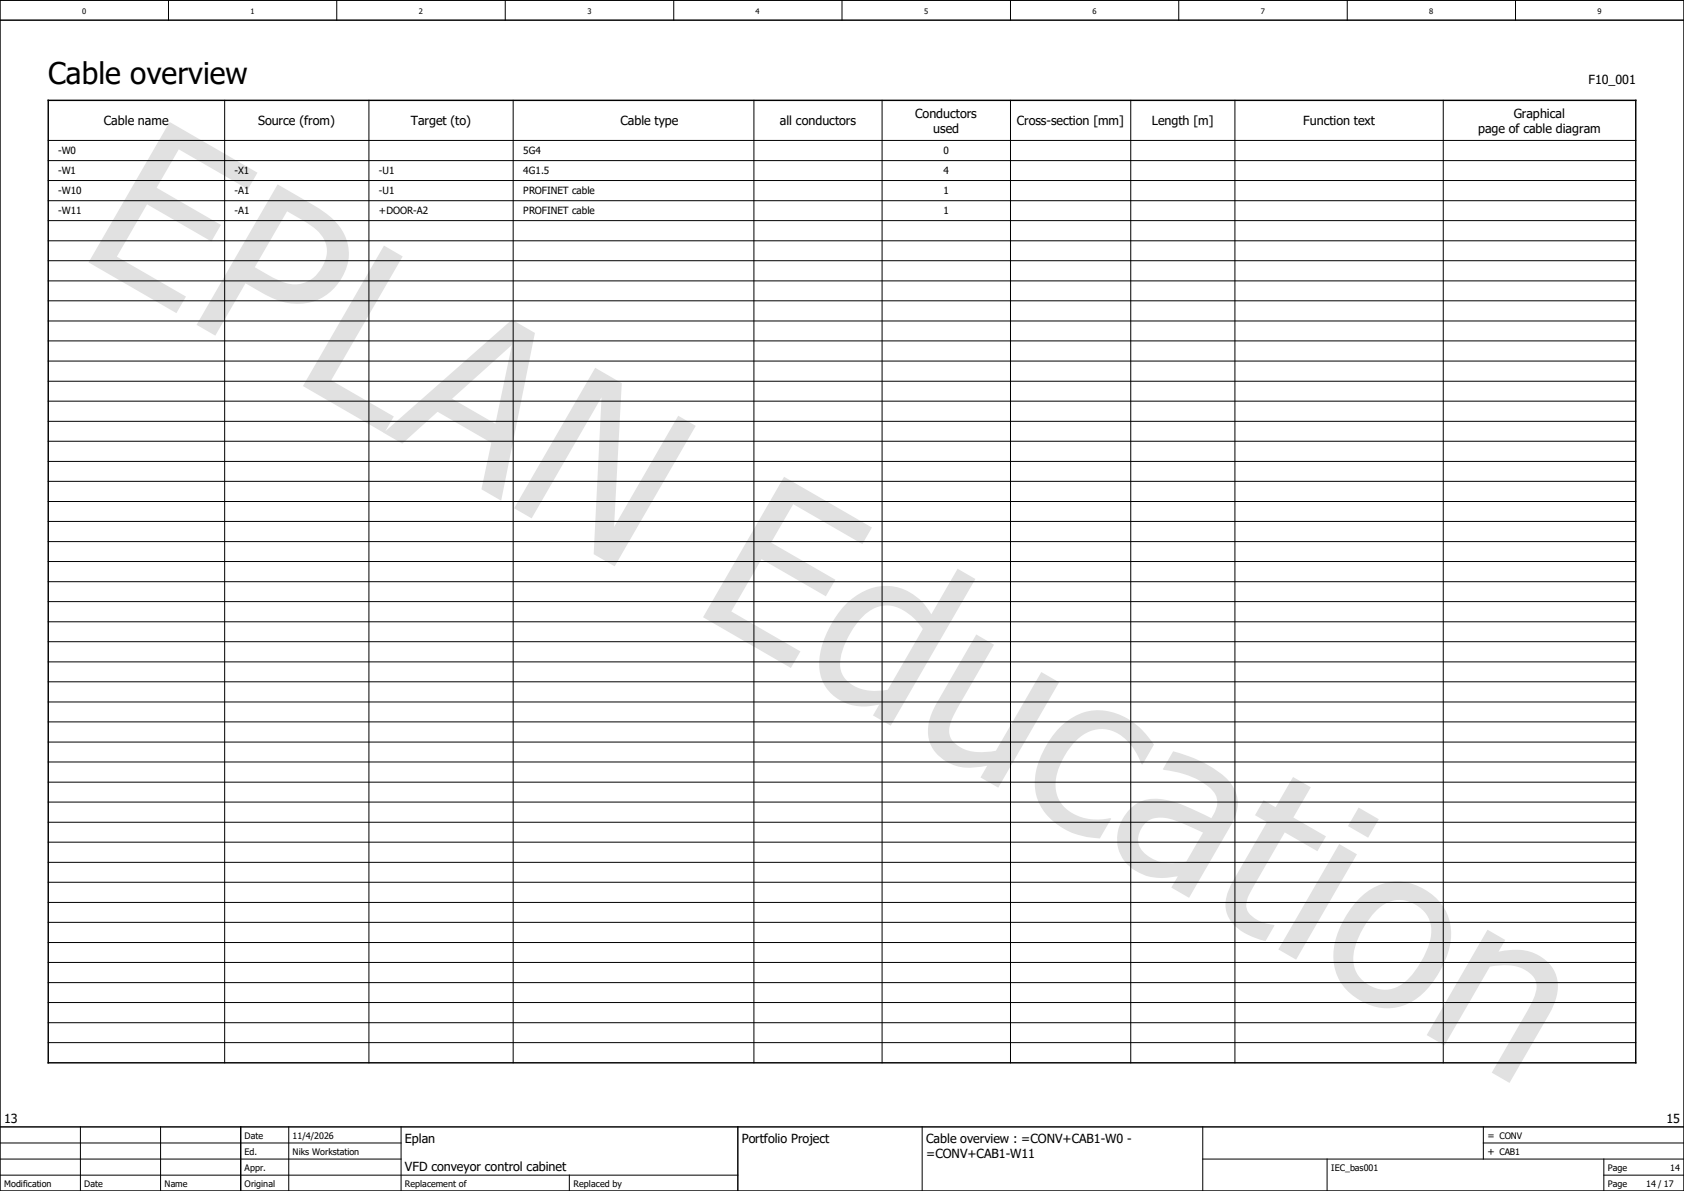
[picture p17: page 14]

Cable name | | | Cable type | all conductors | Conductors used Target (to) | Cross-section [mm] | Length [m] | Function text | Graphical page of cable diagram Source (from)

-W0 | | | 5G4 | | 0
-W1 | -X1 | -U1 | 4G1.5 | | 4
-W10 | | -U1 | PROFINET cable -A1 | | 1
-W11 | | +DOOR-A2 | PROFINET cable -A1 | | 1

Cable overview : =CONV+CAB1-W0 -
=CONV+CAB1-W11

# Device tag list

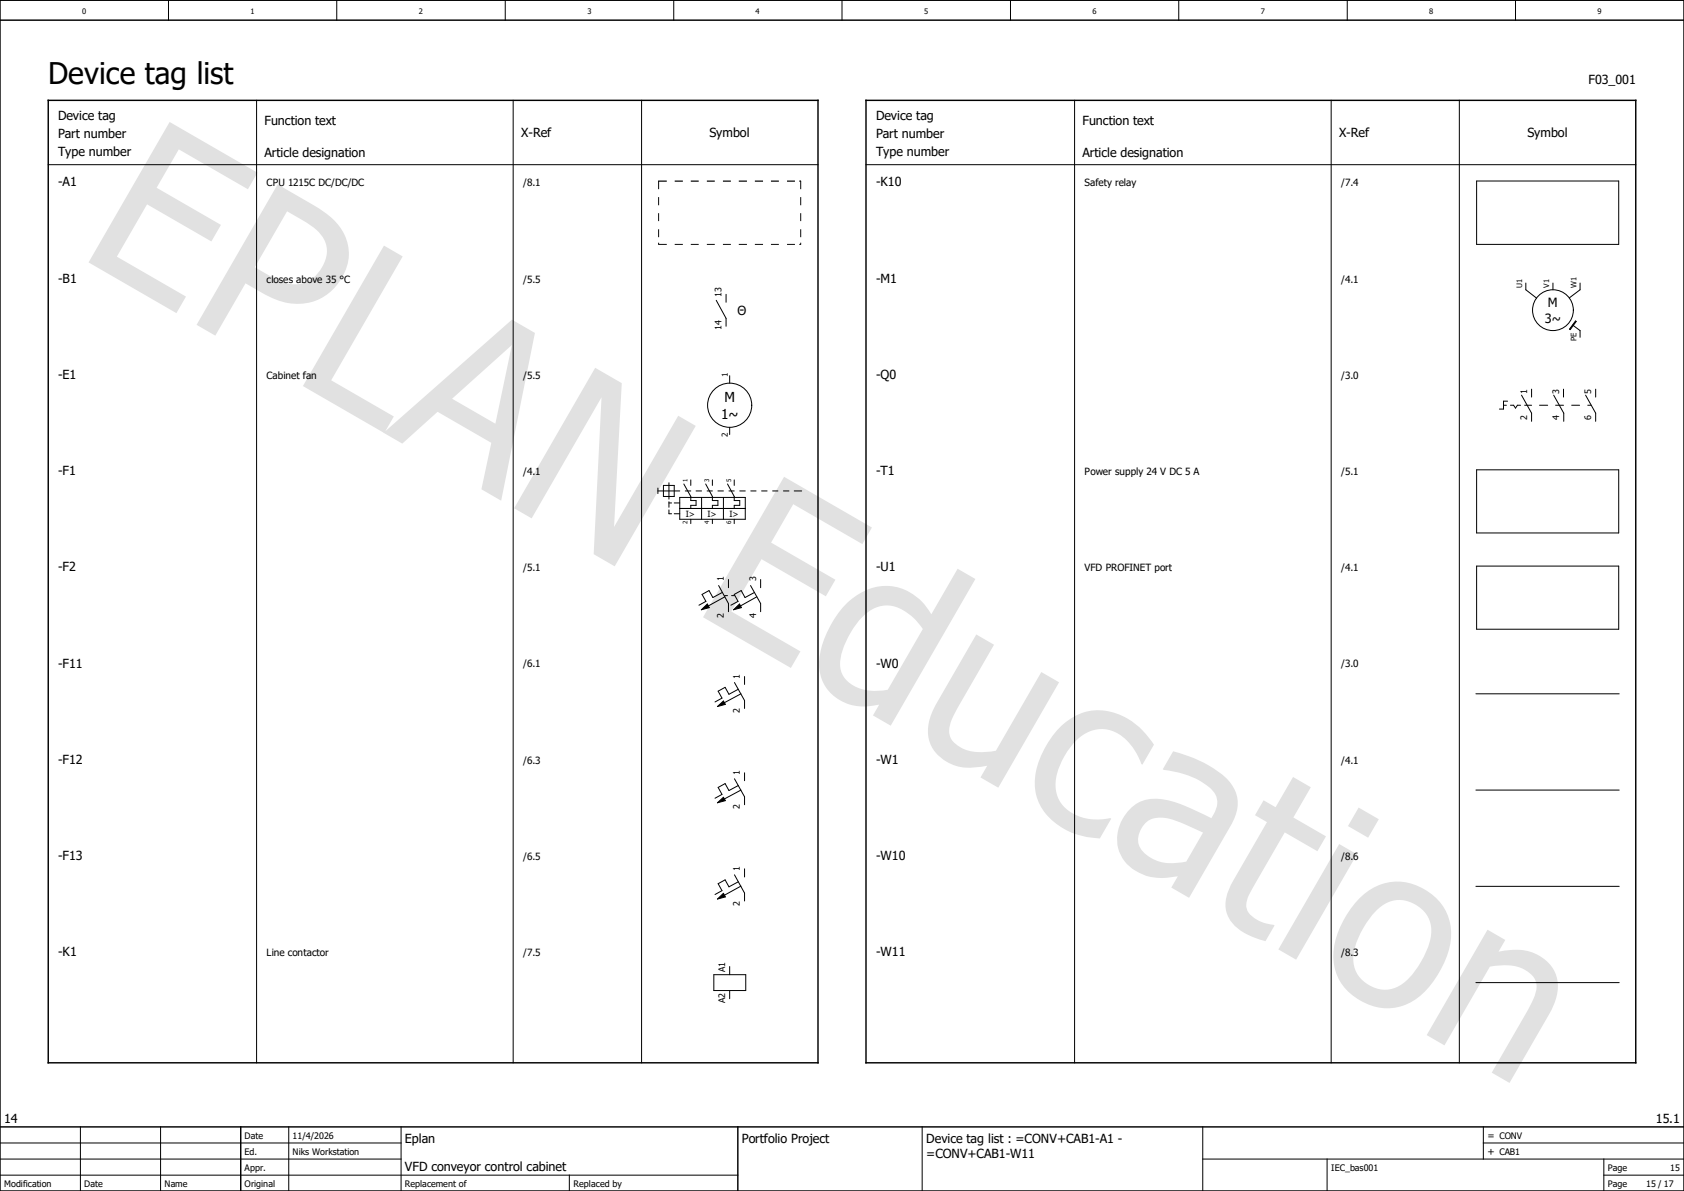
[picture p18: page 15]
Type number; Symbol; Article designation; Part number; Device tag; Function text; X-Ref; X-Ref 13 14; CPU 1215C DC/DC/DC; closes above 35 °C; Cabinet fan; Line contactor; Safety relay; Power supply 24 V DC 5 A; VFD PROFINET port

Device tag list : =CONV+CAB1-A1 -
=CONV+CAB1-W11

# Device tag list

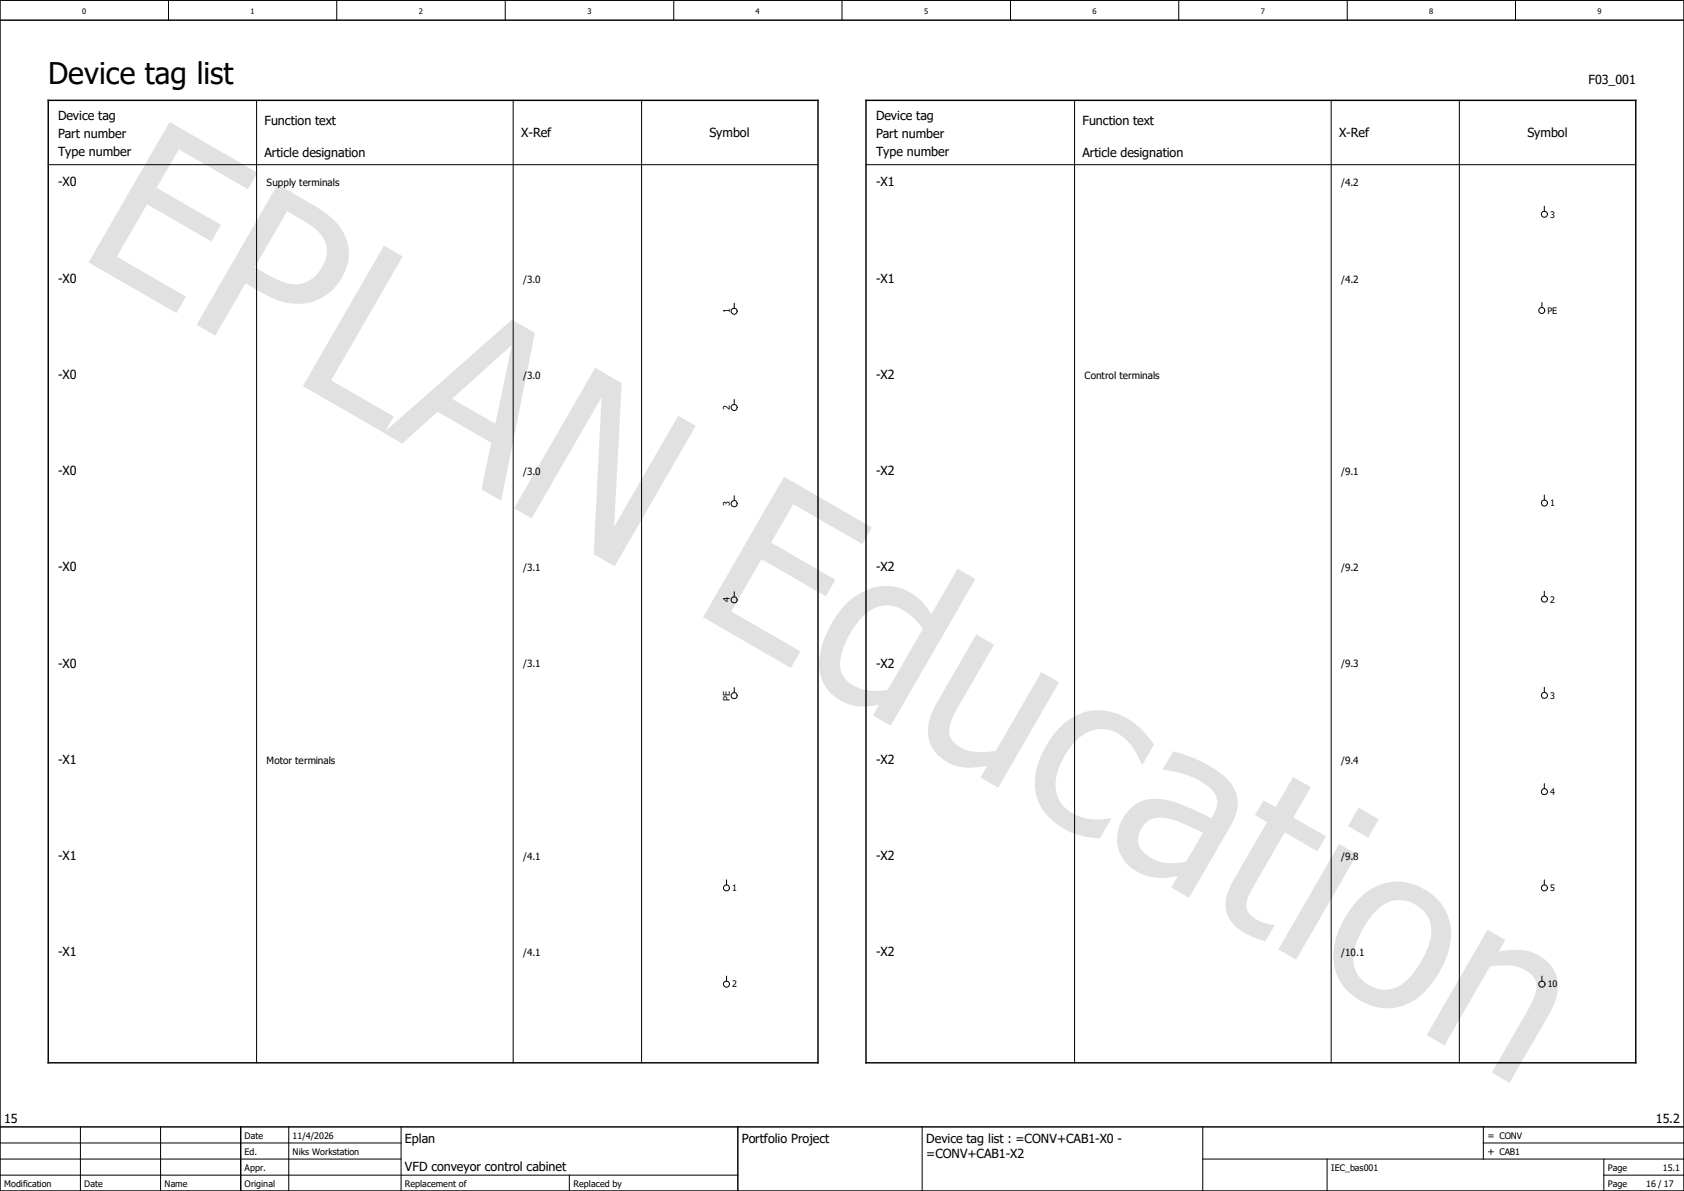
[picture p19: page 16]
Type number; Symbol; Article designation; Part number; Device tag; Function text; X-Ref; X-Ref 1 2 3 4 PE 1; Supply terminals; Motor terminals; Control terminals

Device tag list : =CONV+CAB1-X0 -
=CONV+CAB1-X2

# Device tag list

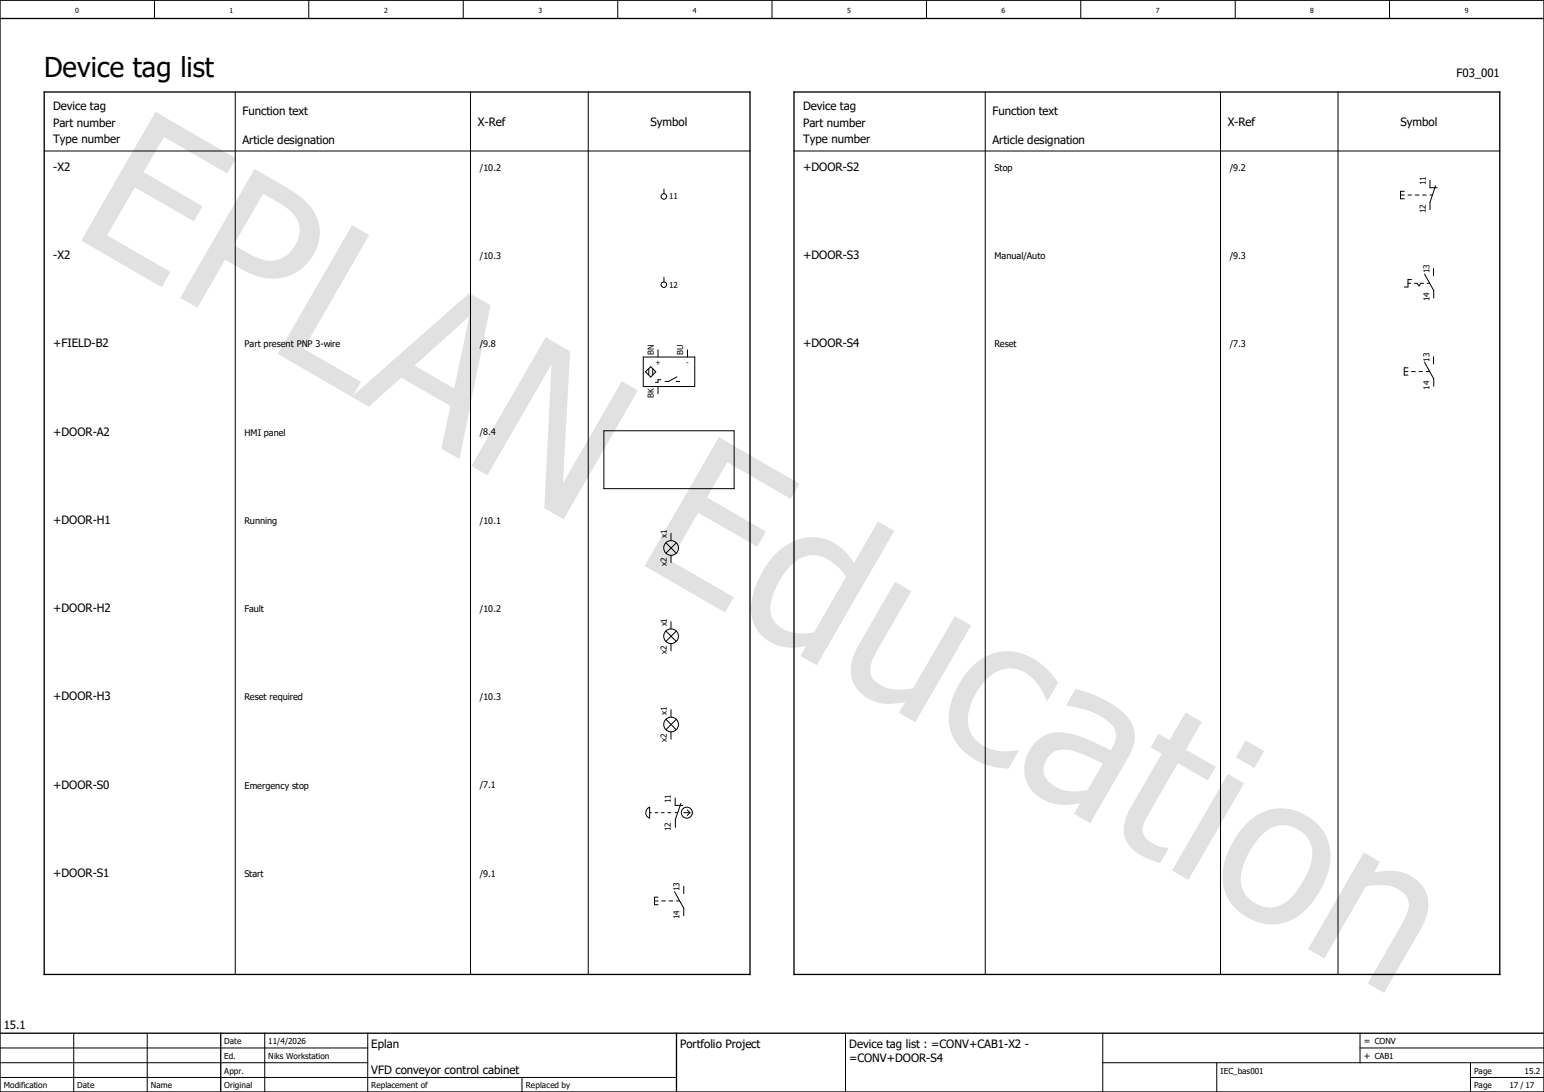
[picture p20: page 17]
Type number; Symbol; Article designation; Part number; Device tag; Function text; X-Ref; +FIELD-B2; Part present PNP 3-wire; +DOOR-A2; HMI panel; +DOOR-H1; Running; +DOOR-H2; Fault; +DOOR-H3; Reset required; +DOOR-S0; Emergency stop; +DOOR-S1; Start; +DOOR-S2; Stop; +DOOR-S3; Manual/Auto; +DOOR-S4; Reset

Device tag list : =CONV+CAB1-X2 -
=CONV+DOOR-S4
