nikspolaroid/eplan-vfd-conveyor-cabinet/(commit log)

2026-11-04 EPLAN P8 schematic: VFD conveyor control cabinet
    Pages 1-15 with power infeed, drive, 230 V and 24 V supplies, E-stop safety
    circuit, PLC I/O and PROFINET; generated reports; project check 0 errors.
2026-11-06 Add Fusion 3D cabinet layout
    3D model of the CAB1 cabinet generated by a Fusion Python script from the
    EPLAN device list: enclosure, door devices with legends, mounting plate with
    ducts, DIN rails, all devices tagged as in the schematic, and terminal strips.
    Includes the .f3d design, a STEP export, the generator script and renders,
    and a README section describing the layout.
    [CAB1_VFD_conveyor_cabinet.f3d, CAB1_VFD_conveyor_cabinet.step]
